Glaubinator/Radio-Telescope-RCA/README.md

# Radio-Telescope-RCA
Radio Telescope System for 1 GHz to 2 GHz Operation
