Glaubinator/Radio-Telescope-RCA/CAD/CAD.dwg/2pc Compressed 2 sheets.pdf

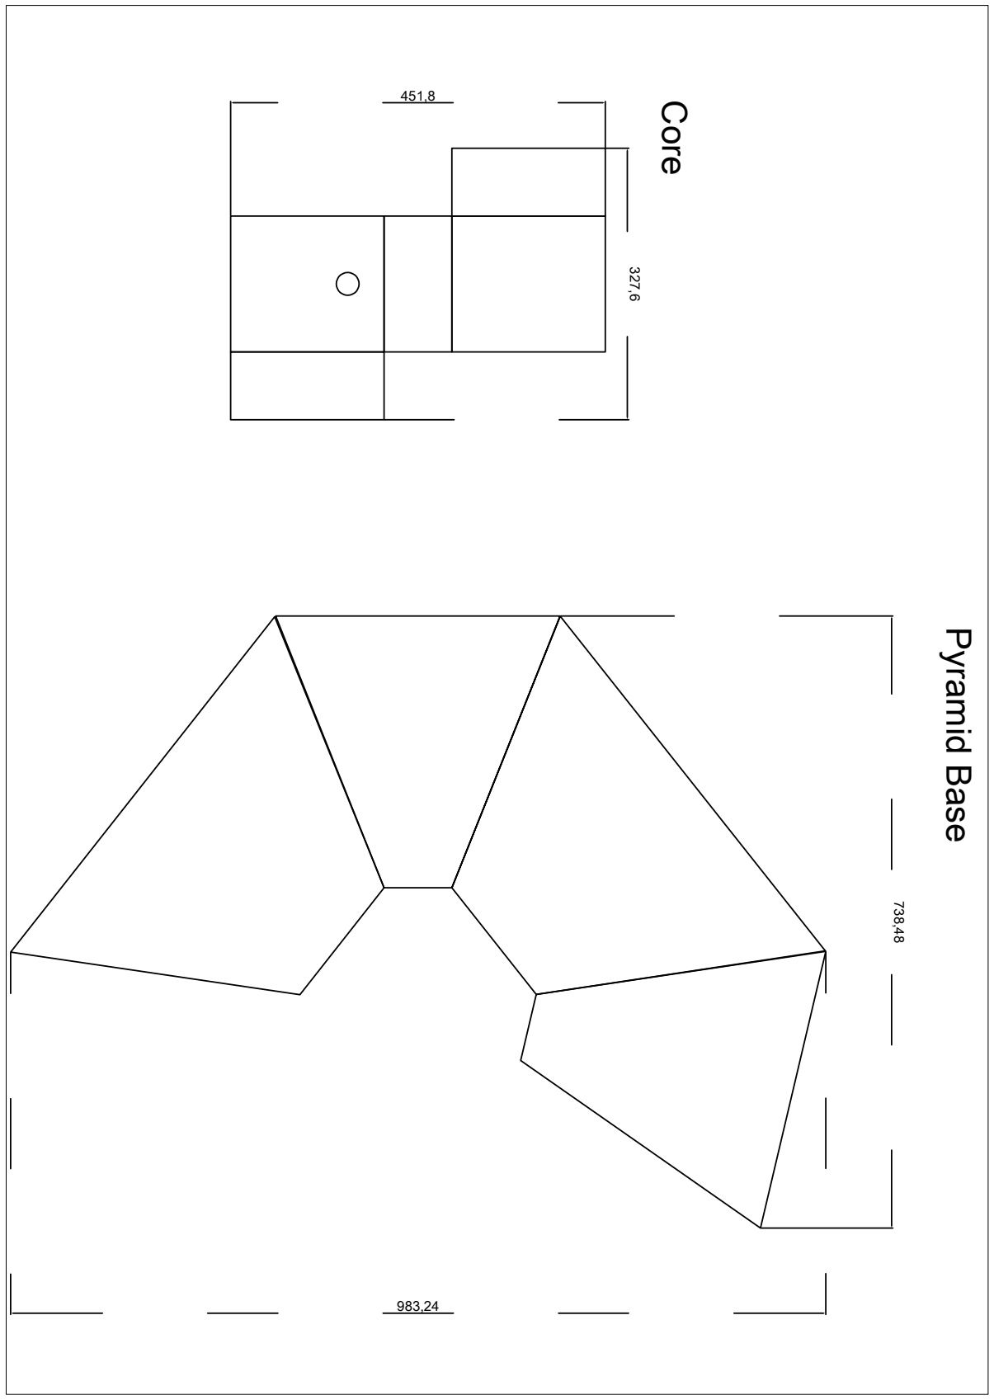
[picture p8: figure]
Pyramid Base ³²⁷,6; Core
