Glaubinator/Radio-Telescope-RCA/Project Info and Requirements/Decision Matrices/SDR Software.xlsx

SDR Softwares
Criteria | Weight | SDRAngel | SDR++ | GQRX
Ease of Use/UI | 3 | 2 | 4 | 5
Features/Expandability | 5 | 5 | 3 | 2
Recent Revisioning | 3 | 5 | 4 | 2
Score |  | 35 | 35 | 35
 | Criteria | Analysis
 | Ease of Use/UI | Most difficult, need to add interface windows for specific features, more of a canvas-style tool that can be configured to user's liking. | Bit more difficult to get use to, UI is understandable to navigate | Very easy to use, UI is simple
 | Features/Expandability | Best feature set compared to others, has special features for radio astronomy (rotator controls, skymaps, radio astronomy viewer) | Medium-low feature set, has similar features as GQRX but in a more presentable manner. Highlights common frequency ranges for HAM, FM, AM, etc. | Small feature set, really only meant for listening to radio waves. Lack of features may limit the expansibility of project later on.
 | Recent Revisioning | Dec 4, 2024 (As of 1/24/2025), Roughly Monthly Updates | Jan 3, 2025 (As of 1/24/2025), Nightly Builds | Nov 29, 2024 (As of 1/24/2025), updates semi-quarterly
 | Cost | FREE | FREE | FREE
 | Construction | Metal | Metal | Plastic
 | Compatibility with Software | Mostly compatible | Requires additional libraries | Mostly compatible
 | Cost | $340 | $133 | $233.25
