Glaubinator/Radio-Telescope-RCA/Project Info and Requirements/Functional Decomposition/Block Diagram/Level 0 and Level 1.png

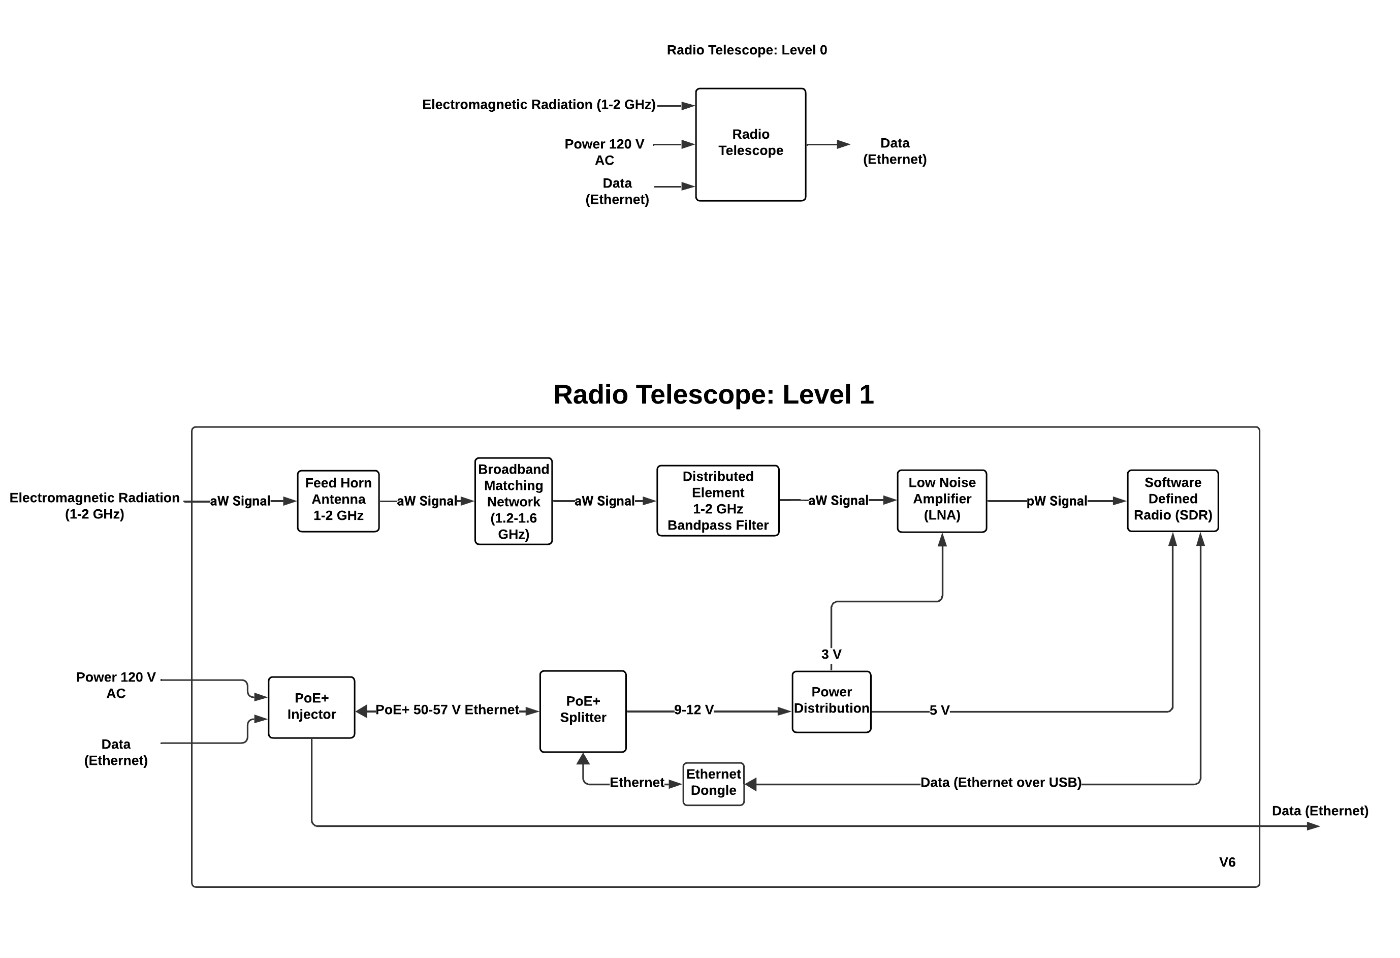
Project Info and Requirements/Functional Decomposition/Block Diagram/Level 0 and Level 1.png
