Glaubinator/Radio-Telescope-RCA/Project Info and Requirements/Gantt Chart/RCA RadioTelescope1.1.png

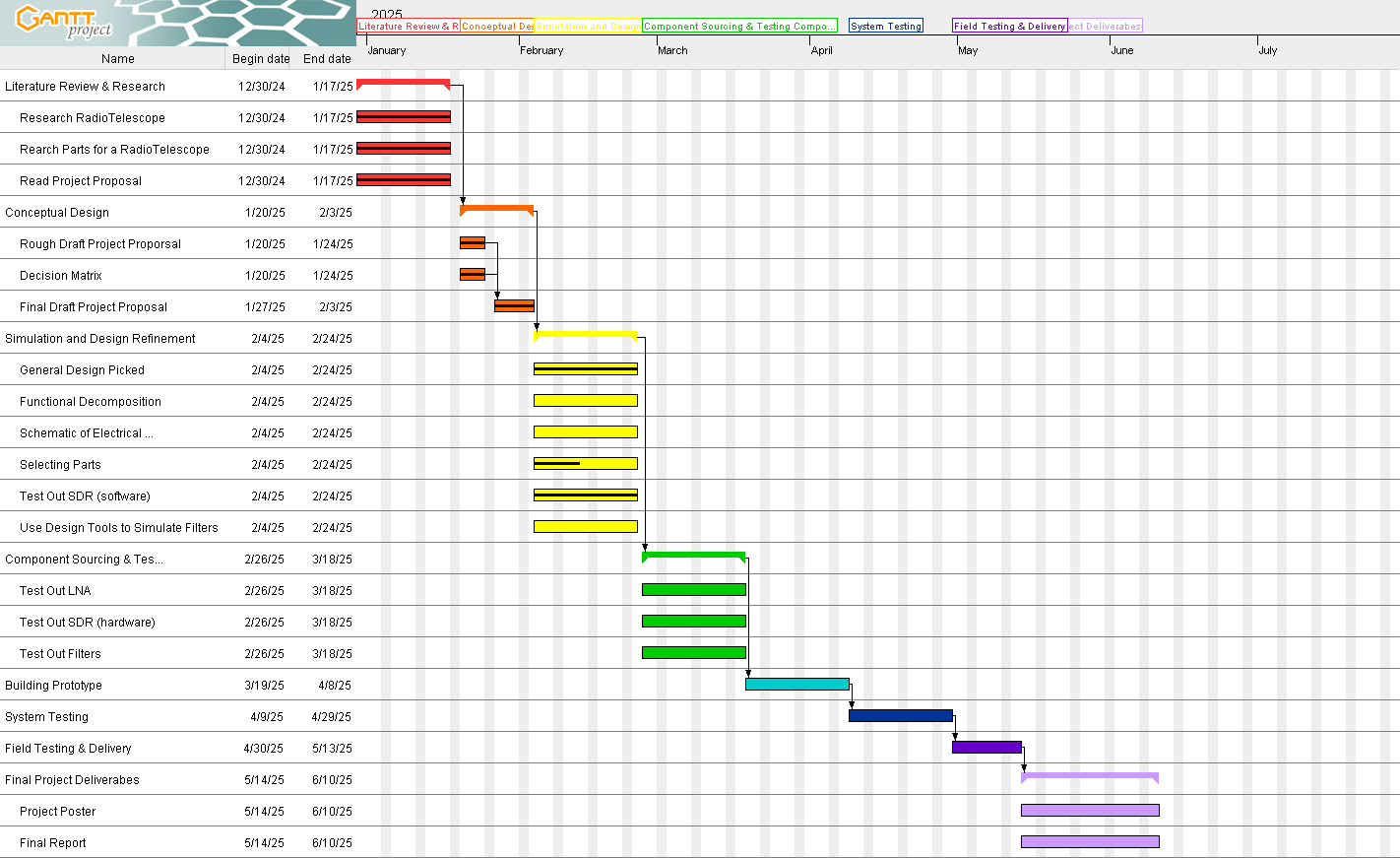
Project Info and Requirements/Gantt Chart/RCA RadioTelescope1.1.png
