Glaubinator/Radio-Telescope-RCA/Project Info and Requirements/Gantt Chart/RCA RadioTelescopeV1.2.png

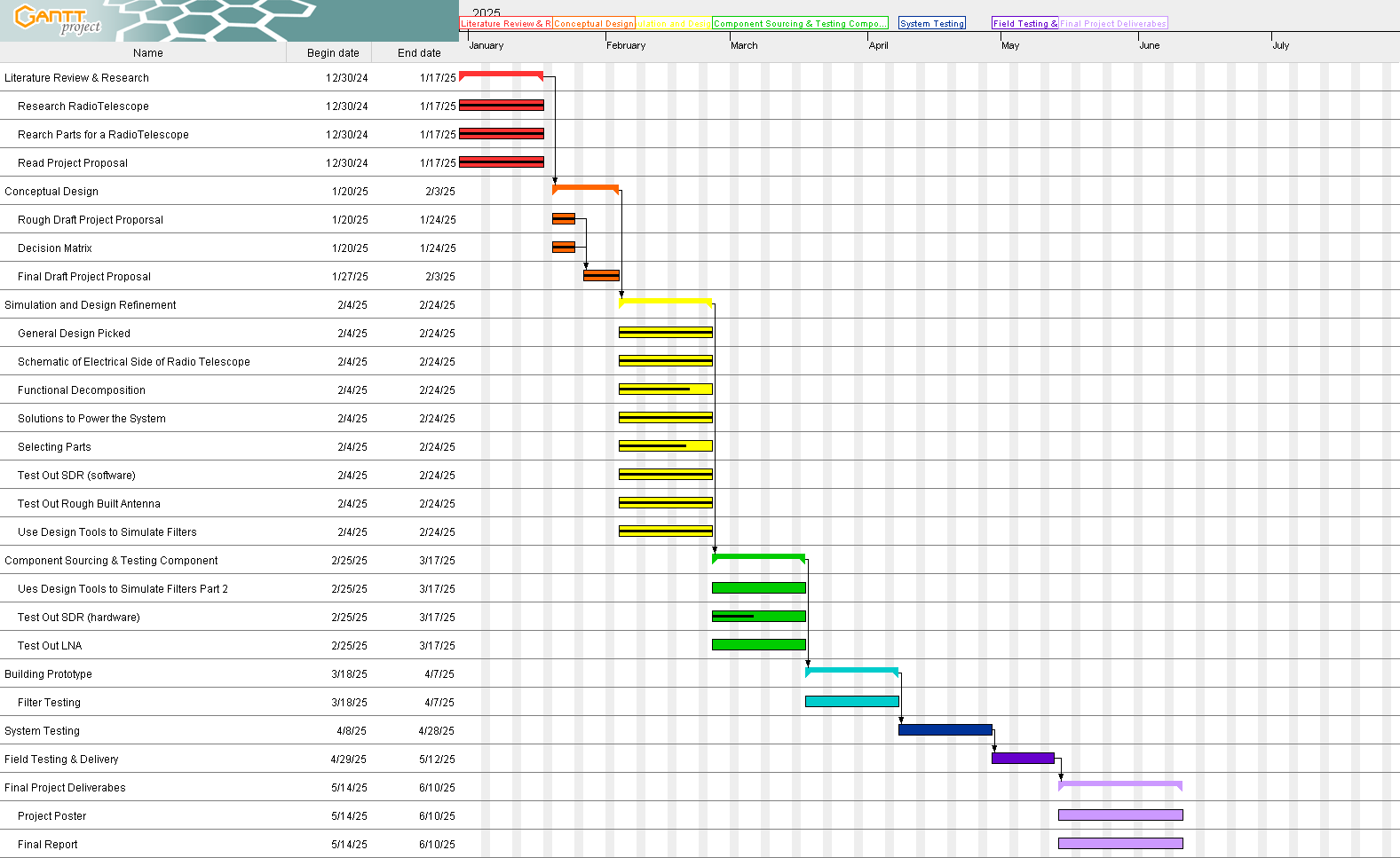
Project Info and Requirements/Gantt Chart/RCA RadioTelescopeV1.2.png
