Glaubinator/Radio-Telescope-RCA/Project Info and Requirements/Gantt Chart/RCA RadioTelescopeV1.4.png

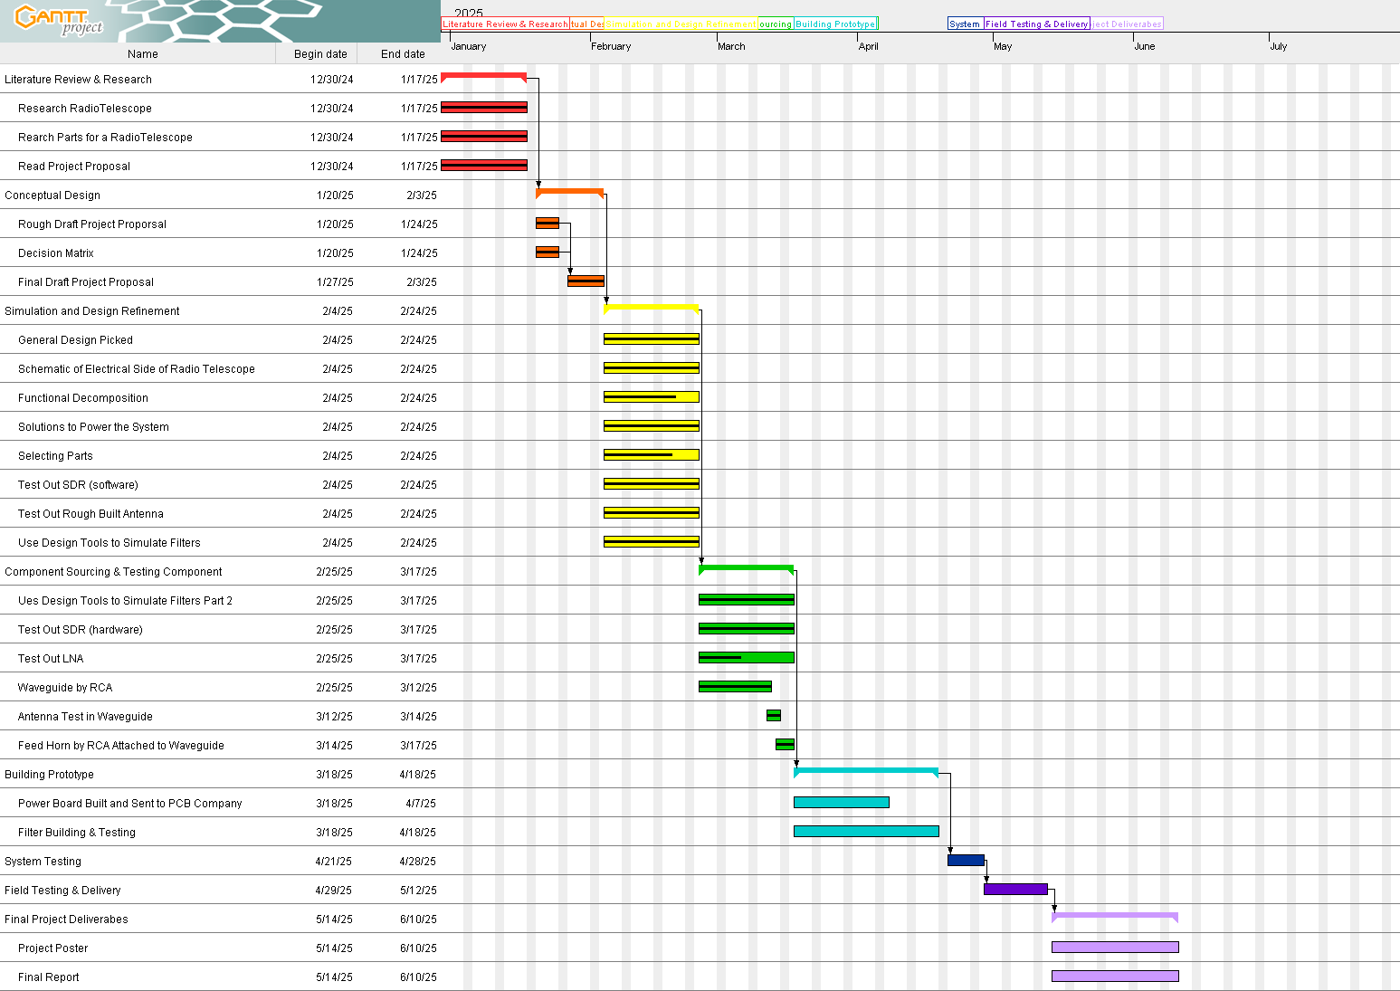
Project Info and Requirements/Gantt Chart/RCA RadioTelescopeV1.4.png
