Glaubinator/Radio-Telescope-RCA/Project Info and Requirements/Gantt Chart/RCA RadioTelescopeV1.6.png

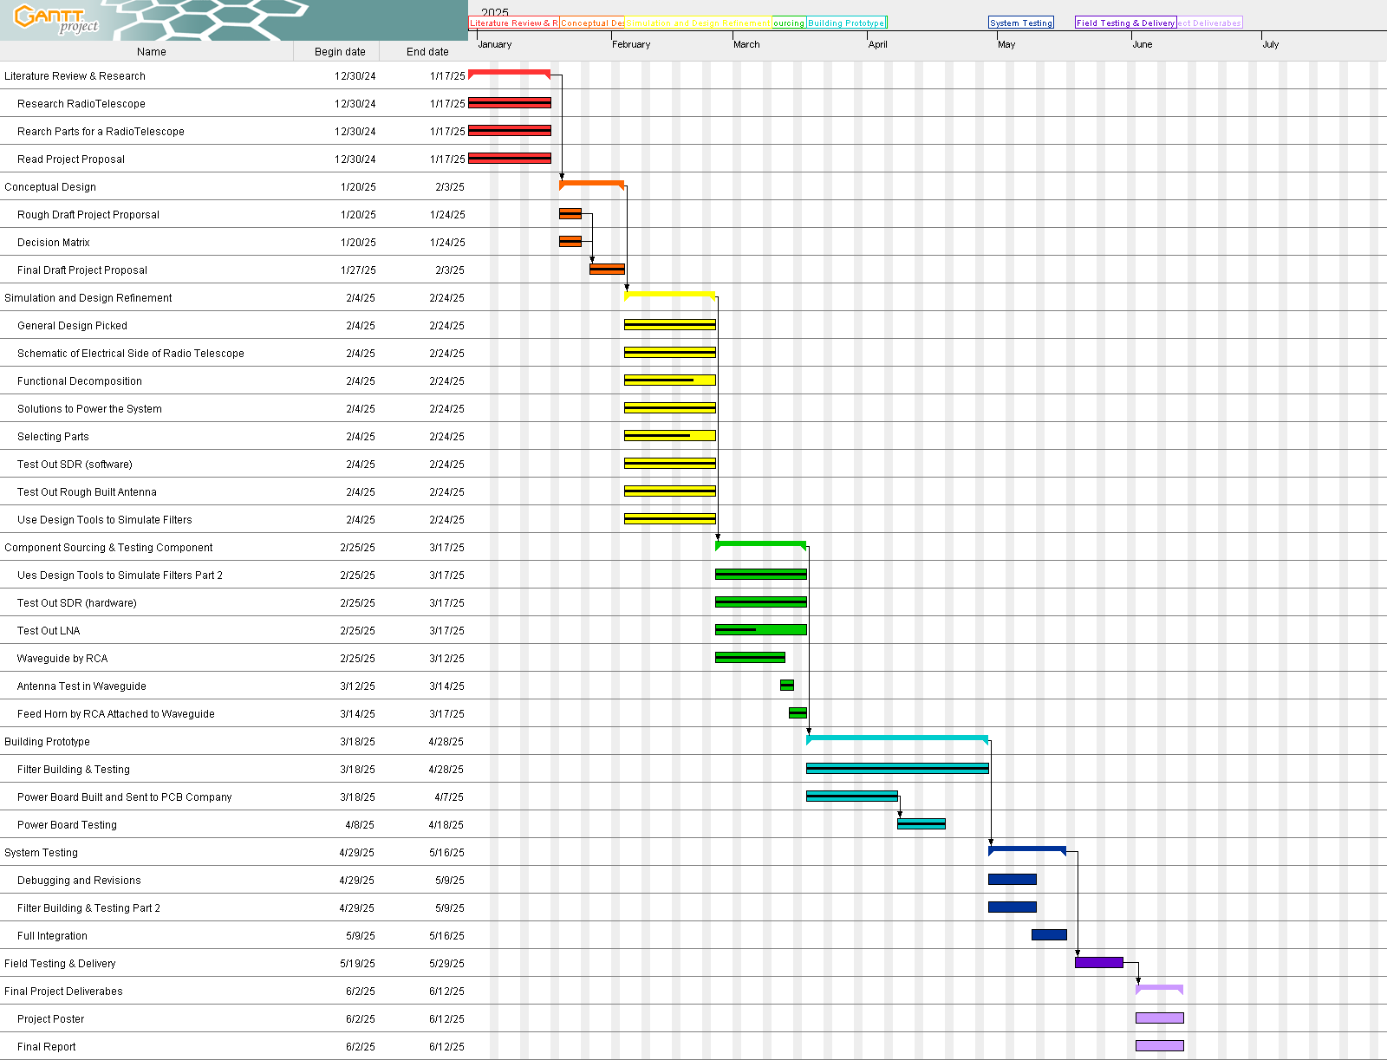
Project Info and Requirements/Gantt Chart/RCA RadioTelescopeV1.6.png
