Glaubinator/Radio-Telescope-RCA/Project Info and Requirements/Simulations/ADS/RF_Board V2/RFBOARDV2/pictures/ddsClipboard.png

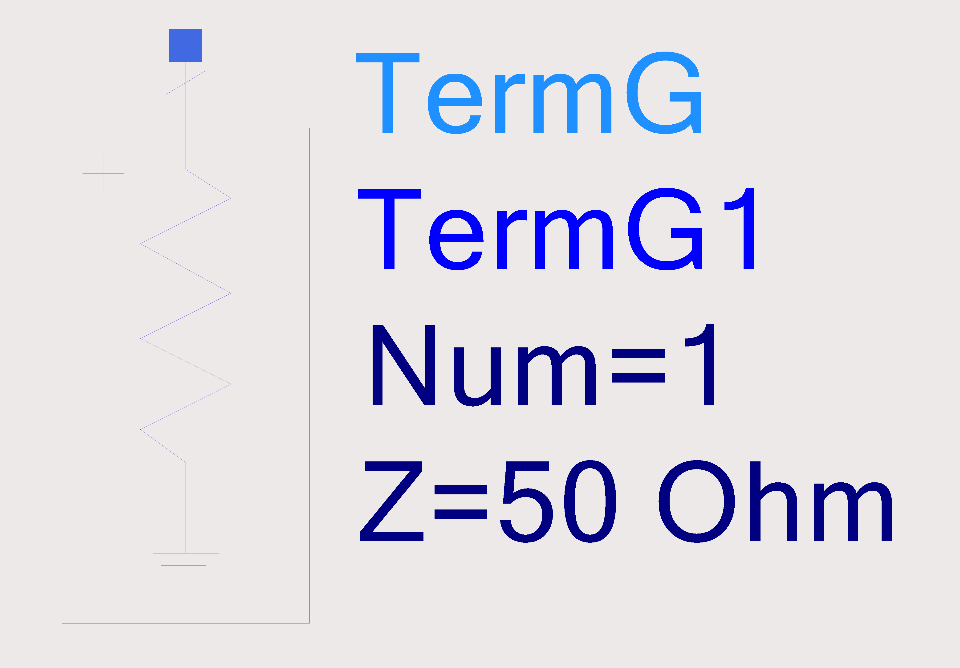
Project Info and Requirements/Simulations/ADS/RF_Board V2/RFBOARDV2/pictures/ddsClipboard.png
