Glaubinator/Radio-Telescope-RCA/CAD/3D Printables/Power.stp

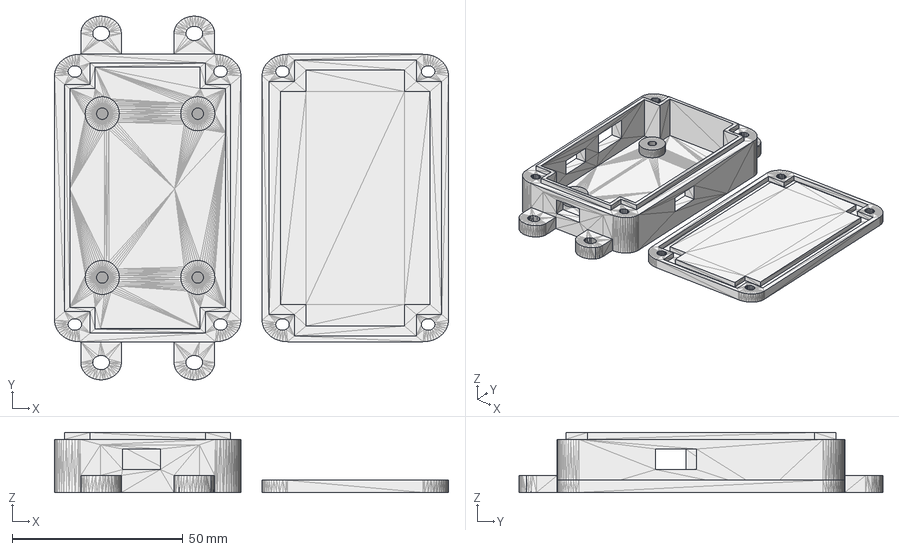
[picture p15: CAD file, 2025-05-12]
CAD/3D Printables/Power.stp
115.5 x 106.6 x 17.6 mm
