Glaubinator/Radio-Telescope-RCA/CAD/KiCad PCB-Schematic/RCA Radio Telescope (MultiPCB)/KiKit Exports/RF Boards/MDF_PCB_Rev1-3/Models/142-0711-821.stp

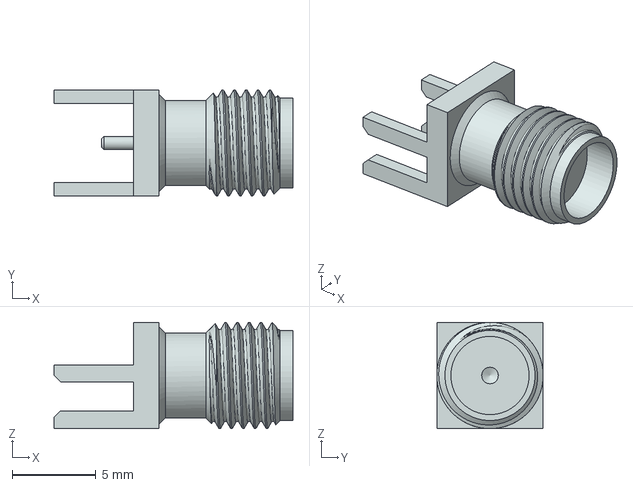
[picture p16: CAD file, 2025-05-06]
CAD/KiCad PCB-Schematic/RCA Radio Telescope (MultiPCB)/KiKit Exports/RF Boards/MDF_PCB_Rev1-3/Models/142-0711-821.stp
14.3 x 6.35 x 6.35 mm
