Glaubinator/Radio-Telescope-RCA/CAD/KiCad PCB-Schematic/RCA Radio Telescope (MultiPCB)/KiKit Exports/RF Boards/RFS_PCB_Rev1-4.step

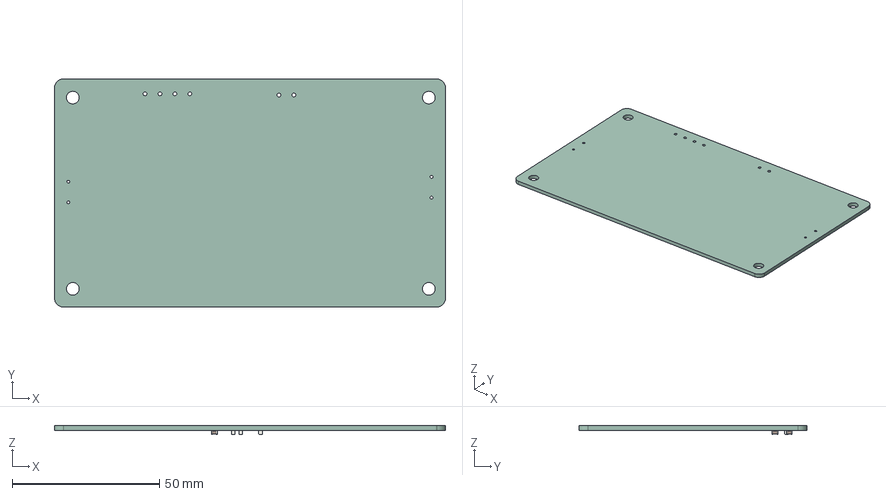
[picture p17: CAD file, 2025-05-07]
CAD/KiCad PCB-Schematic/RCA Radio Telescope (MultiPCB)/KiKit Exports/RF Boards/RFS_PCB_Rev1-4.step
132.9 x 77.5 x 2.90 mm
C_0805_2012Metric x 4
_autosave-RFS_PCB_Rev1-4_PCB
