Glaubinator/Radio-Telescope-RCA/CAD/3D Printables/MDF.stl

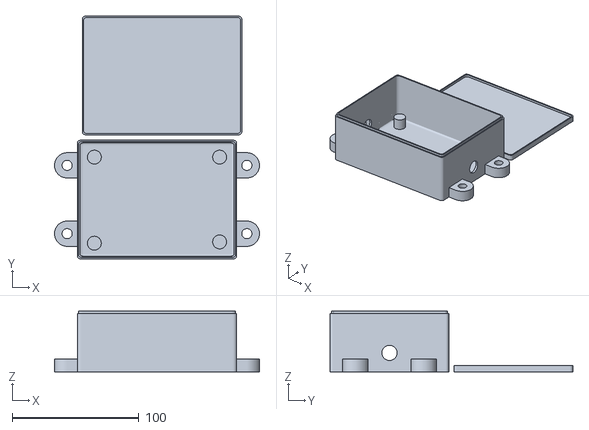
[picture p18: CAD file, 2025-05-12]
CAD/3D Printables/MDF.stl
162.0 x 192.0 x 48.0
