Glaubinator/Radio-Telescope-RCA/CAD/KiCad PCB-Schematic/RCA Radio Telescope (MultiPCB)/KiKit Exports/RF Boards/SF_PCB_Rev1-4.step

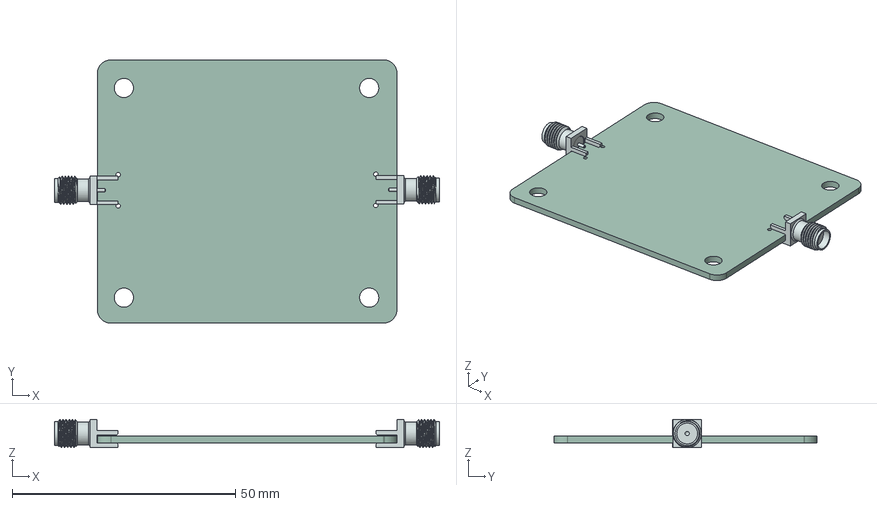
[picture p19: CAD file, 2025-05-06]
CAD/KiCad PCB-Schematic/RCA Radio Telescope (MultiPCB)/KiKit Exports/RF Boards/SF_PCB_Rev1-4.step
86.3 x 59.0 x 6.35 mm
SF_PCB_Rev1-4_PCB
