Glaubinator/Radio-Telescope-RCA/CAD/KiCad PCB-Schematic/RCA Radio Telescope (MultiPCB)/Models/DCU0008A.stp

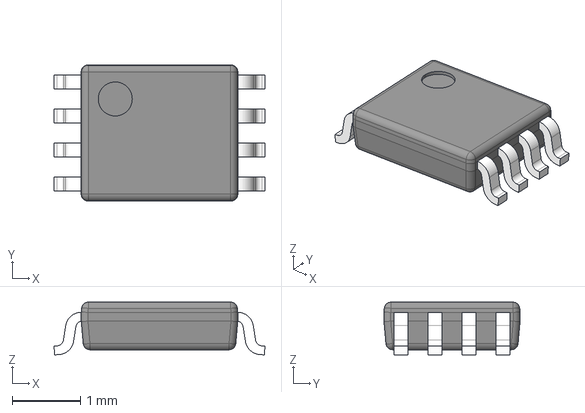
[picture p20: CAD file, 2025-04-02]
CAD/KiCad PCB-Schematic/RCA Radio Telescope (MultiPCB)/Models/DCU0008A.stp
3.10 x 2.00 x 0.775 mm
BODY-VSSOP
LEAD-VSSOP x 8
