Glaubinator/Radio-Telescope-RCA/CAD/3D Printables/RFS.stl

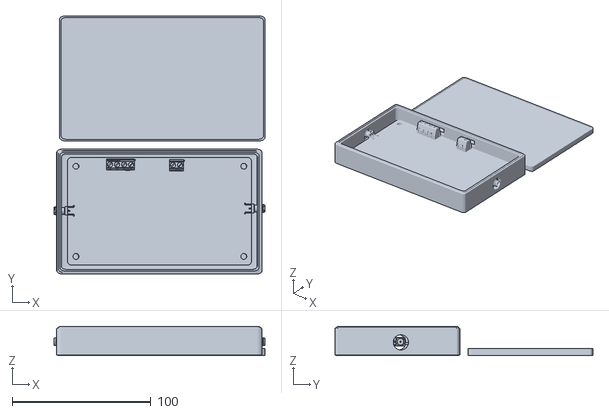
[picture p21: CAD file, 2025-05-09]
CAD/3D Printables/RFS.stl
152.0 x 186.0 x 21.0
