Glaubinator/Radio-Telescope-RCA/CAD/KiCad PCB-Schematic/RCA Radio Telescope (MultiPCB)/KiKit Exports/RF Boards/MSF_PCB_Rev1-3.step

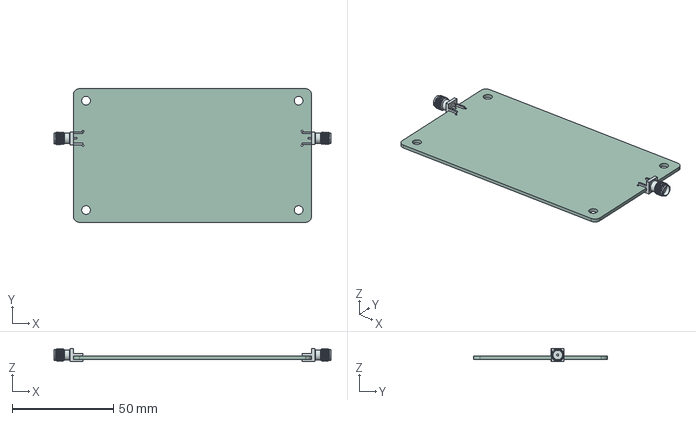
[picture p22: CAD file, 2025-05-06]
CAD/KiCad PCB-Schematic/RCA Radio Telescope (MultiPCB)/KiKit Exports/RF Boards/MSF_PCB_Rev1-3.step
136.8 x 66.0 x 6.35 mm
MSF_PCB_Rev1-3_PCB
