Glaubinator/Radio-Telescope-RCA/CAD/KiCad PCB-Schematic/RCA Radio Telescope (MultiPCB)/Models/SC-70_C5_MCH.step

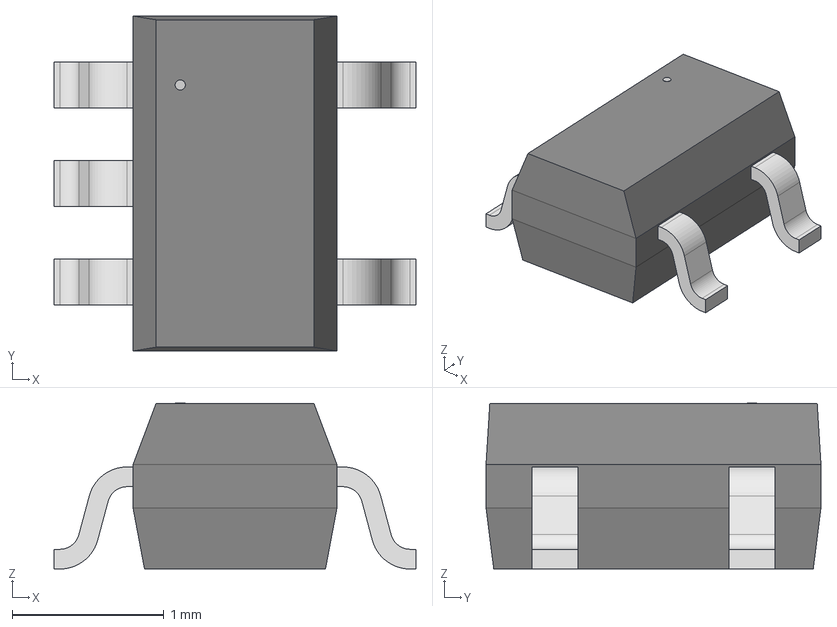
[picture p23: CAD file, 2025-04-02]
CAD/KiCad PCB-Schematic/RCA Radio Telescope (MultiPCB)/Models/SC-70_C5_MCH.step
2.39 x 2.21 x 1.09 mm
