Glaubinator/Radio-Telescope-RCA/CAD/3D Printables/MSF.stl

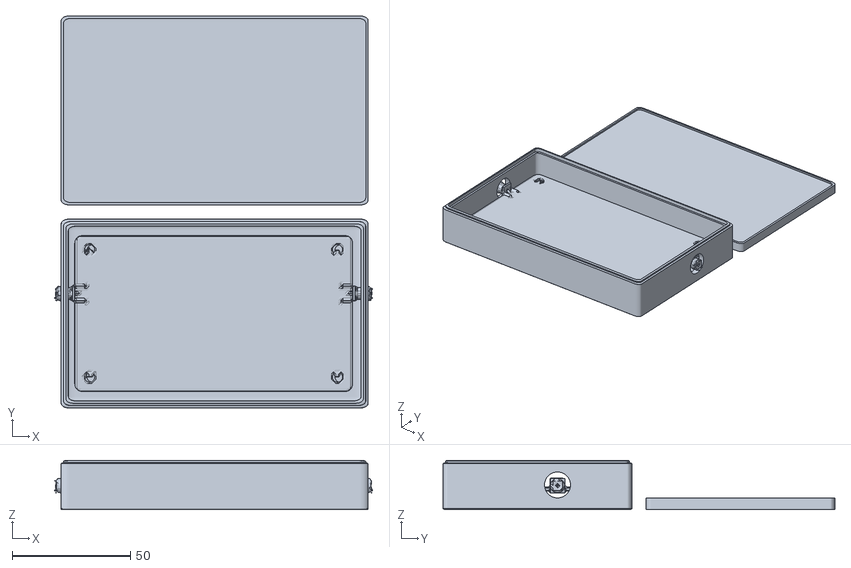
[picture p24: CAD file, 2025-05-07]
CAD/3D Printables/MSF.stl
135.0 x 166.0 x 21.0
