Glaubinator/Radio-Telescope-RCA/CAD/KiCad PCB-Schematic/RCA Radio Telescope (MultiPCB)/KiKit Exports/RF Boards/MDF_PCB_Rev1-3.step

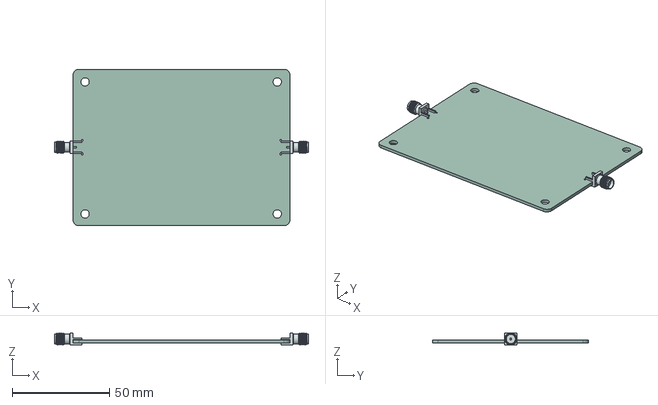
[picture p25: CAD file, 2025-05-06]
CAD/KiCad PCB-Schematic/RCA Radio Telescope (MultiPCB)/KiKit Exports/RF Boards/MDF_PCB_Rev1-3.step
130.8 x 80.5 x 6.35 mm
MDF_PCB_Rev1-3_PCB
