Glaubinator/Radio-Telescope-RCA/CAD/KiCad PCB-Schematic/RCA Radio Telescope (MultiPCB)/Models/MIC5365-1.8YC5-TR.step

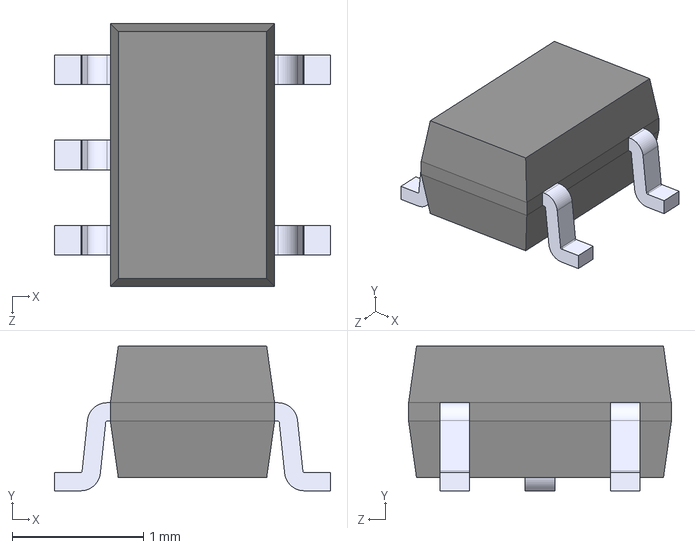
[picture p26: CAD file, 2025-04-02]
CAD/KiCad PCB-Schematic/RCA Radio Telescope (MultiPCB)/Models/MIC5365-1.8YC5-TR.step
2.10 x 1.10 x 2.00 mm
