Glaubinator/Radio-Telescope-RCA/CAD/3D Printables/SF.stl

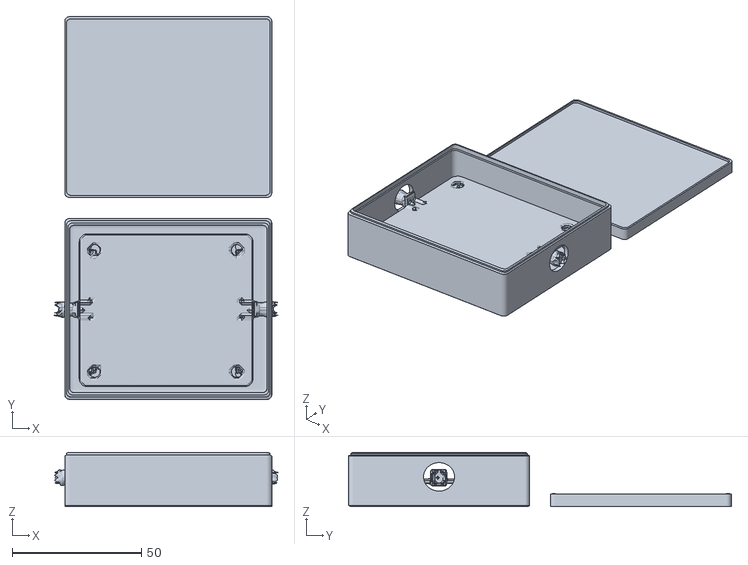
[picture p27: CAD file, 2025-05-07]
CAD/3D Printables/SF.stl
86.2 x 148.0 x 21.0
