Glaubinator/Radio-Telescope-RCA/CAD/KiCad PCB-Schematic/RCA Radio Telescope (MultiPCB)/Models/IND_CB_DRA73.step

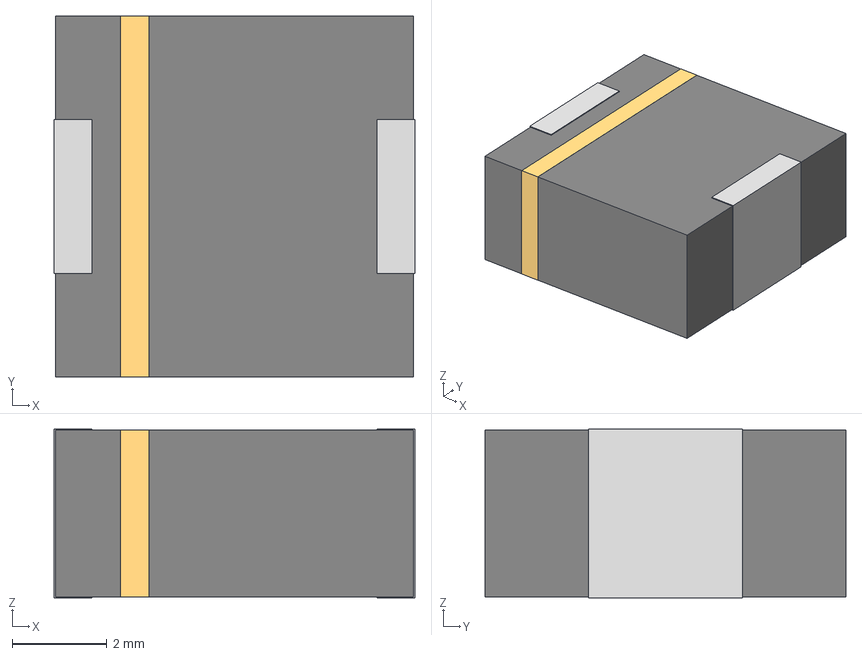
[picture p28: CAD file, 2025-03-29]
CAD/KiCad PCB-Schematic/RCA Radio Telescope (MultiPCB)/Models/IND_CB_DRA73.step
7.59 x 7.60 x 3.56 mm
