Glaubinator/Radio-Telescope-RCA/CAD/3D Printables/Power Print V1.stl

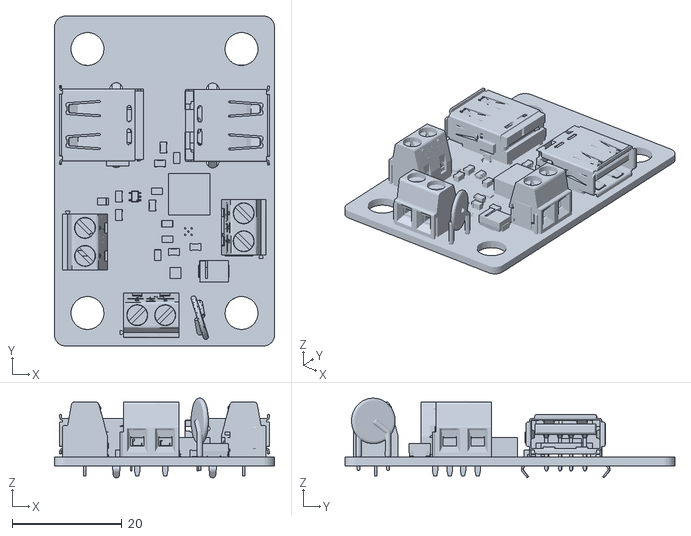
[picture p29: CAD file, 2025-04-26]
CAD/3D Printables/Power Print V1.stl
40.0 x 60.0 x 14.5
