Glaubinator/Radio-Telescope-RCA/CAD/KiCad PCB-Schematic/RCA Radio Telescope (MultiPCB)/Models/SMB_DIO.step

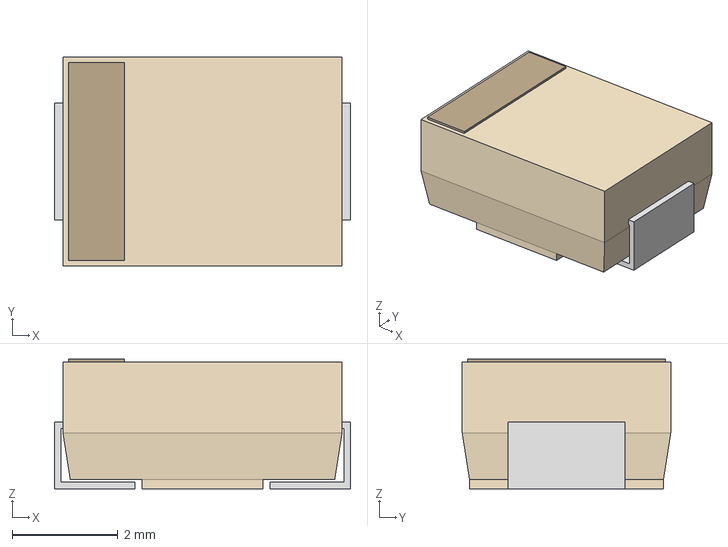
[picture p30: CAD file, 2025-03-29]
CAD/KiCad PCB-Schematic/RCA Radio Telescope (MultiPCB)/Models/SMB_DIO.step
5.59 x 3.94 x 2.45 mm
