Glaubinator/Radio-Telescope-RCA/CAD/KiCad PCB-Schematic/RCA Radio Telescope (MultiPCB)/Models/DFN2020E-6_STP.STP

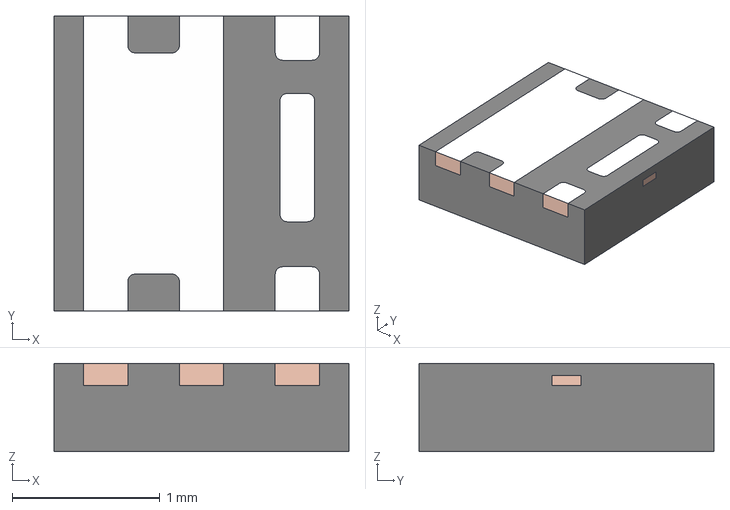
[picture p31: CAD file, 2025-03-29]
CAD/KiCad PCB-Schematic/RCA Radio Telescope (MultiPCB)/Models/DFN2020E-6_STP.STP
2.00 x 2.00 x 0.6 mm
Coumpound
LF
