Glaubinator/Radio-Telescope-RCA/CAD/KiCad PCB-Schematic/RCA Radio Telescope (MultiPCB)/Models/RGT0016C.stp

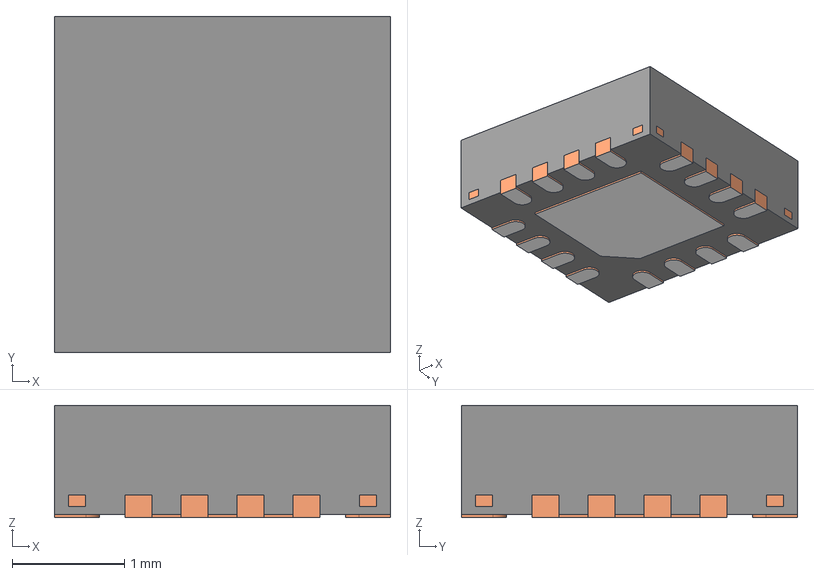
[picture p32: CAD file, 2025-03-29]
CAD/KiCad PCB-Schematic/RCA Radio Telescope (MultiPCB)/Models/RGT0016C.stp
3.00 x 3.00 x 1.00 mm
BODY-QFN
FRAME-RGT0016C
PIN1-ID
