Glaubinator/Radio-Telescope-RCA/CAD/KiCad PCB-Schematic/RCA Radio Telescope (MultiPCB)/Models/MAX8510EXK30T.step

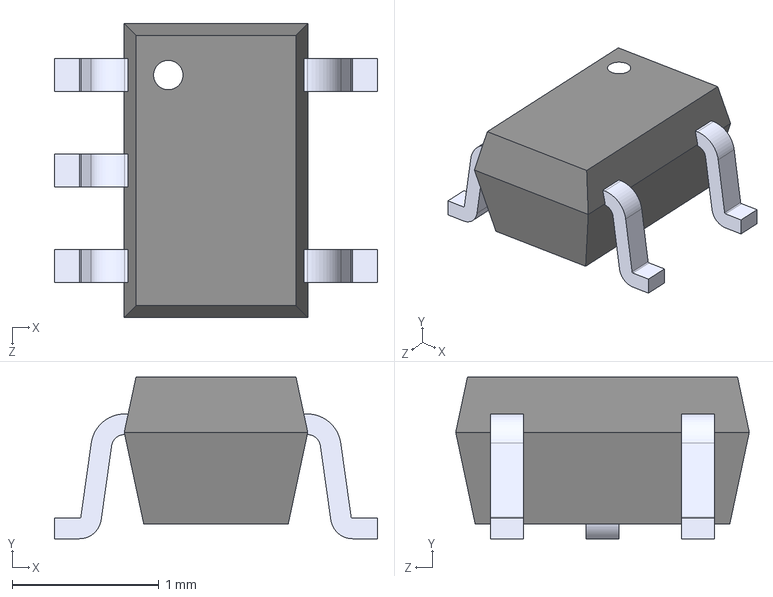
[picture p33: CAD file, 2025-03-28]
CAD/KiCad PCB-Schematic/RCA Radio Telescope (MultiPCB)/Models/MAX8510EXK30T.step
2.20 x 1.10 x 2.00 mm
