Glaubinator/Radio-Telescope-RCA/(list of files, cad)

Other CAD files:
CAD/CAD.dwg/2pc compressed-no-dims.dwg
CAD/Enclosure/Enclosure V2.dwg
CAD/FeedHorn/flange.dwg
Project Info and Requirements/Simulations/ADS/RF_Board V2/RFBOARDV2/mfg/RFBOARDV2_lib_1.6 GHz Matching With Filter/dxf/1.dxf
CAD/CAD.dwg/1pc-1sheet.dwg
CAD/FeedHorn/flange no filled.dwg
CAD/CAD.dwg/2pc compressed-no-dims-pdf.dwg
CAD/FeedHorn/flange union.dwg
CAD/CAD.dwg/Orgami-dim.dwg
CAD/FeedHorn/flange no fill.dwg
CAD/CAD.dwg/REG_HID_LAY_HTX.dwg
CAD/3D Printables/Power.stl
CAD/Enclosure/Enclosure.dwg
CAD/KiCad PCB-Schematic/RCA Radio Telescope (MultiPCB)/KiKit Exports/RF Boards/RFS_PCB_Rev1-3/Models/1729128.stp
CAD/KiCad PCB-Schematic/RCA Radio Telescope (MultiPCB)/KiKit Exports/RF Boards/RFS_PCB_Rev1-3/Models/1729144.stp
Project Info and Requirements/Simulations/ADS/Distrbuted Element Filter/simulation/ece413capstonecoupledlinedesign_lib/InterdigitalFilterOnly/layout/emSetup_MoM/proj.prt
Project Info and Requirements/Simulations/ADS/Distrbuted Element Filter/simulation/ece413capstonecoupledlinedesign_lib/InterdigitalFilterOnly/layout/emSetup_MoM/proj_out.prt
Project Info and Requirements/Simulations/ADS/Distrbuted Element Filter/simulation/ece413capstonecoupledlinedesign_lib/InterdigitalV3/layout/emSetup_MoM/proj.prt
Project Info and Requirements/Simulations/ADS/Distrbuted Element Filter/simulation/ece413capstonecoupledlinedesign_lib/InterdigitalV3/layout/emSetup_MoM/proj_out.prt
Project Info and Requirements/Simulations/ADS/Distrbuted Element Filter/simulation/ece413capstonecoupledlinedesign_lib/InterdigitalV3/layout/emSetup_export2EMPro/proj.prt
Project Info and Requirements/Simulations/ADS/RF_Board V2/RFBOARDV2/simulation/RFBOARDV2_lib/BroadbandmatchingNetwork/layout/emSetup_MoM/proj.prt
Project Info and Requirements/Simulations/ADS/RF_Board V2/RFBOARDV2/simulation/RFBOARDV2_lib/BroadbandmatchingNetwork/layout/emSetup_MoM/proj_out.prt
