Glaubinator/Radio-Telescope-RCA/Project Info and Requirements/RCA - Radio Telescope System for 1 GHz to 2 GHz Operation (UPDATED, 01_07_2025).pdf

## Project Proposal: Senior Engineering Capstone Design Project

## Title: Design and Build of a Radio Telescope System for 1 GHz to 2 GHz Operation

### 0. Background:

Rose City Astronomers (RCA) is an organization of amateur astronomers dedicated to the promotion, education, and enjoyment of astronomy among its members and the public. (https://www.rosecityastronomers.net)

RCA is beginning activity in radio astronomy for the interest of its members, and community. RCA has chosen to support educational projects with partner institutions. Initial projects in this area will explore suitable equipment for amateur radio astronomy observations and equip RCA with assets for use at its dark sky site, and for educational outreach in Greater Portland and other locations. The proposed project documented here is RCA’s first educational project specific to radio astronomy.

### 1. Project Objectives

The goal of this project is to design, build, and test a working prototype of a radio telescope system for operation in the 1 GHz to 2 GHz frequency range. The system will be used for amateur radio astronomy and include key components such as:

- A Low Noise Amplifier (LNA)
- A 3-meter parabolic dish antenna with 1/4 wave-in-horn waveguide feed
- A Software Defined Radio (SDR)
- FPGA-based signal processing and interfacing with a laptop PC running amateur radio astronomy software.

This system will meet stringent design specifications for performance, robustness, and cost while demonstrating the ability to detect weak celestial signals, such as those at 1.42 GHz (Hydrogen Line).

### 2. Customer Specifications

### 2.1 Low Noise Amplifier (LNA):

- Gain: ≥ 30 dB across 1 GHz – 2 GHz
- Noise Figure: ≤ 0.7 dB
- Power Supply: 12 V DC
- Power Consumption: ≤ 600 W over 12 hours continuous use
- Temperature Stability: -25°C to +60°C (passive heat sink if required)

### 2.2 Parabolic Dish Antenna:

- Diameter: 3 meters
- Surface Deviation: Root Mean Square deviation < wavelength/10 as fabricated and assembled
- Material: Aluminum mesh surface with structural tube frame
- Mounting: Manual adjustment ±180° azimuth, ±90° altitude without >3% parabola deformation from gravity load
- Wind Load Resistance: Withstand up to 90 mph winds without >3% parabola deformation
- Feed Design: 1/4 wave ground plane vertical, replaceable for each: 1 GHz, 1.42 GHz, and 2 GHz operating frequencies, within a horn and waveguide optimized for an f/D ratio = 0.45
- Aperture Efficiency: > 55%
- VSWR: < 1.5
- Antenna Temperature: < 100K at 30-degree elevation

### 2.3 Software Defined Radio (SDR):

- Compatible with Society of Amateur Radio Astronomy (SARA) standards
- Open-source software preferred; licenses ≤ $150 acceptable
- Integration with laptop PC via shielded USB

### 2.4 Signal Processing and Interface:

- FPGA-based processing to achieve:
- Signal Resolution: < 0.0714 rad (< 4.1 degrees) at 1.42 GHz
- Signal-to-Noise Ratio (SNR): ≥ 20:1 under system noise conditions
- Shielded coaxial connections for all critical signal paths

### 2.5 Operational Constraints:

- System budget: ≤ $1000 (BOM only)
- Prototype fabrication, assembly, and testing within 5 calendar months

### 3. Estimated Cost and Timeline

### 3.1 Bill of Materials (BOM) (Preliminary, to be defined by student

project plan and design):

Component Estimated Cost (USD)
Parabolic Dish Antenna (Aluminum Mesh, Frame, Hardware) $400
Low Noise Amplifier (COTS components) | $150
Dipole Feed with Horn and Waveguide | $100
Software Defined Radio (SDR) | $200
FPGA Development Board $100
Shielded Coaxial Cables and Connectors $50

Total Estimated BOM Cost: $1000

### 3.2 Project Timeline (5 Months) (Preliminary, to be defined by

student project plan and design):

Phase Duration | Key Deliverables
1. Literature Review & Research | Weeks 1–2 | Background analysis and requirements doc
2. Conceptual Design | Weeks 3–4 | Two designs with trade-off analysis
3. Simulation & Design Refinement Weeks 5–6 | Performance simulation and selection
4. Component Sourcing | Weeks 7–8 | Procurement of components
5. Prototype Assembly | Weeks 9–11 | Fully assembled system
6. System Testing | Weeks 12–14 | University lab validation
7. Field Testing & Delivery Week 15Deployment to customer dark-sky site

### 4. Design Options and Analysis

- LNA Options: Trade-off between custom design and Commercial Off-The-Shelf (COTS) options to ensure performance and cost balance.
- Antenna Options: Evaluate aluminum mesh construction versus solid dish for weight and cost efficiency.

- Waveguide Design: Horn design will be simulated and optimized for minimal signal loss and best f/D ratio.
- Signal Processing: FPGA platforms like Xilinx or Intel Cyclone evaluated for cost-effectiveness and compatibility.

### 5. Risks and Limitations

### 5.1 Technical Risks:

- Ensuring the LNA noise figure is maintained at ≤ 0.7 dB.
- Achieving sufficient parabolic surface accuracy under environmental loads.
- FPGA signal processing complexity and debugging time.

### 5.2 Budget Constraints:

- Components such as the parabolic dish and SDR must be sourced costeffectively to stay within the $1000 BOM limit.

### 5.3 Environmental Constraints:

- Wind and temperature stability of the dish system, ensuring robustness in the field.

### 5.4 Design Constraints:

- No cryogenic cooling or extreme temperature control systems will be incorporated into the system.
- The system should be modular and scalable for future upgrades or integration into other radio astronomy systems.
- The system shall include coaxial input and output connections and electronics shall be enclosed in a weather tight enclosure, suitably shielded for its specified performance.
- Anticipate that the final project report will be submitted to the “Radio Astronomy, Journal of the Society of Amateur Radio Astronomy.”
- Anticipate presenting the design, prototype performance, and project lessons learned at a General Meeting of the Rose City Astronomers. This is to be scheduled with Mark Martin, Teaching Assistant Professor, PSU.

- The design shall be documented, open source, accessible via arXiv, GitHub, or another reputable open-source server.

### 5.5 Expected Challenges and Risk Mitigation:

- Component Availability: Limited availability of specialized components might affect the timeline. Mitigation: Identify alternative components and commercial off the shelf subsystems early in the design process.
- Prototype Performance: Achieving the target performance metrics (gain, noise figure, etc.) within the specified cost may be challenging. Mitigation: Extensive simulation and design optimization will help reduce the number of prototype iterations required.
- Budget Constraints: Ensuring the BOM stays under $1000 USD could require strategic selection of components. Mitigation: Focus on costeffective transistors and minimize the use of expensive specialized components.

### 6. Skills Required for the Project Team

- Radio Frequency Engineering: For LNA design and waveguide feed analysis.
- Antenna Design and Simulation: Experience with CST Microwave Studio or similar software.
- FPGA Development: Proficiency in VHDL/Verilog and signal processing implementation.
- Software Integration: Experience with SDR hardware and amateur radio astronomy software.
- Mechanical Design: Structural design for the dish antenna and environmental stability.

### 7. Reporting and Milestones

- Weekly Progress Reports: Delivered to project advisor summarizing accomplishments, issues, and corrective actions.
- Key Milestones (Preliminary, to be defined by student project plan and design):
- Completion of conceptual design and simulation (Week 6).
- Assembly of the working prototype (Week 11).

- Validation testing in lab conditions (Week 14).
- Final deployment and field testing (Week 15).

### 8. Conclusion

This project proposal outlines a clear, cost-conscious, and performance-oriented plan to design, build, and test a functional radio telescope prototype. The system will meet the operational needs of amateur radio astronomy while adhering to the defined technical and financial constraints. Successful completion will demonstrate mastery of RF design, FPGA signal processing, and mechanical system development, making it an ideal capstone project for senior engineering students.

Prepared by: [RCA customer / mentor team]
Submission Date: [December 16, 2024]
Advisor/Instructor: [Andrew Greenberg / Mark Martin]
