Glaubinator/Radio-Telescope-RCA/CAD/CAD.dwg/1pc-1sheet-Layout1.pdf

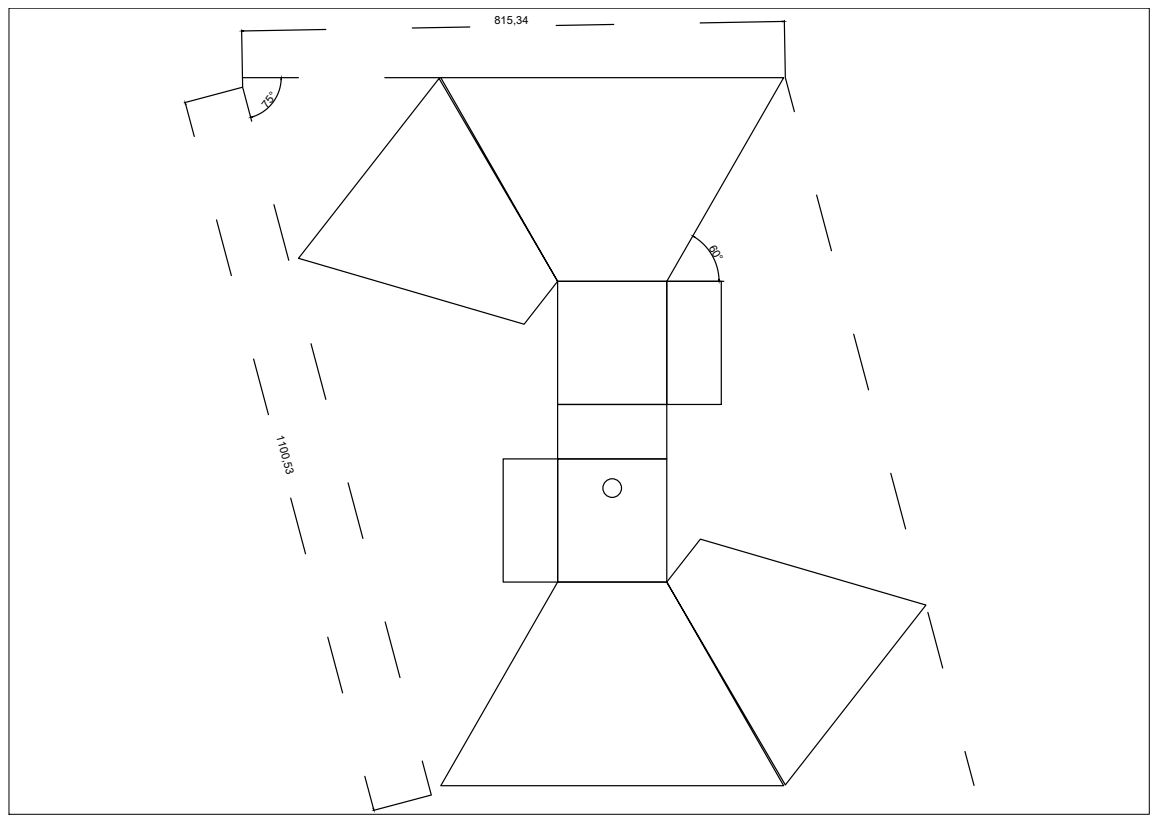
[picture p34: page 1]
