Glaubinator/Radio-Telescope-RCA/CAD/CAD.dwg/Orgami-Dim-Layout1.pdf

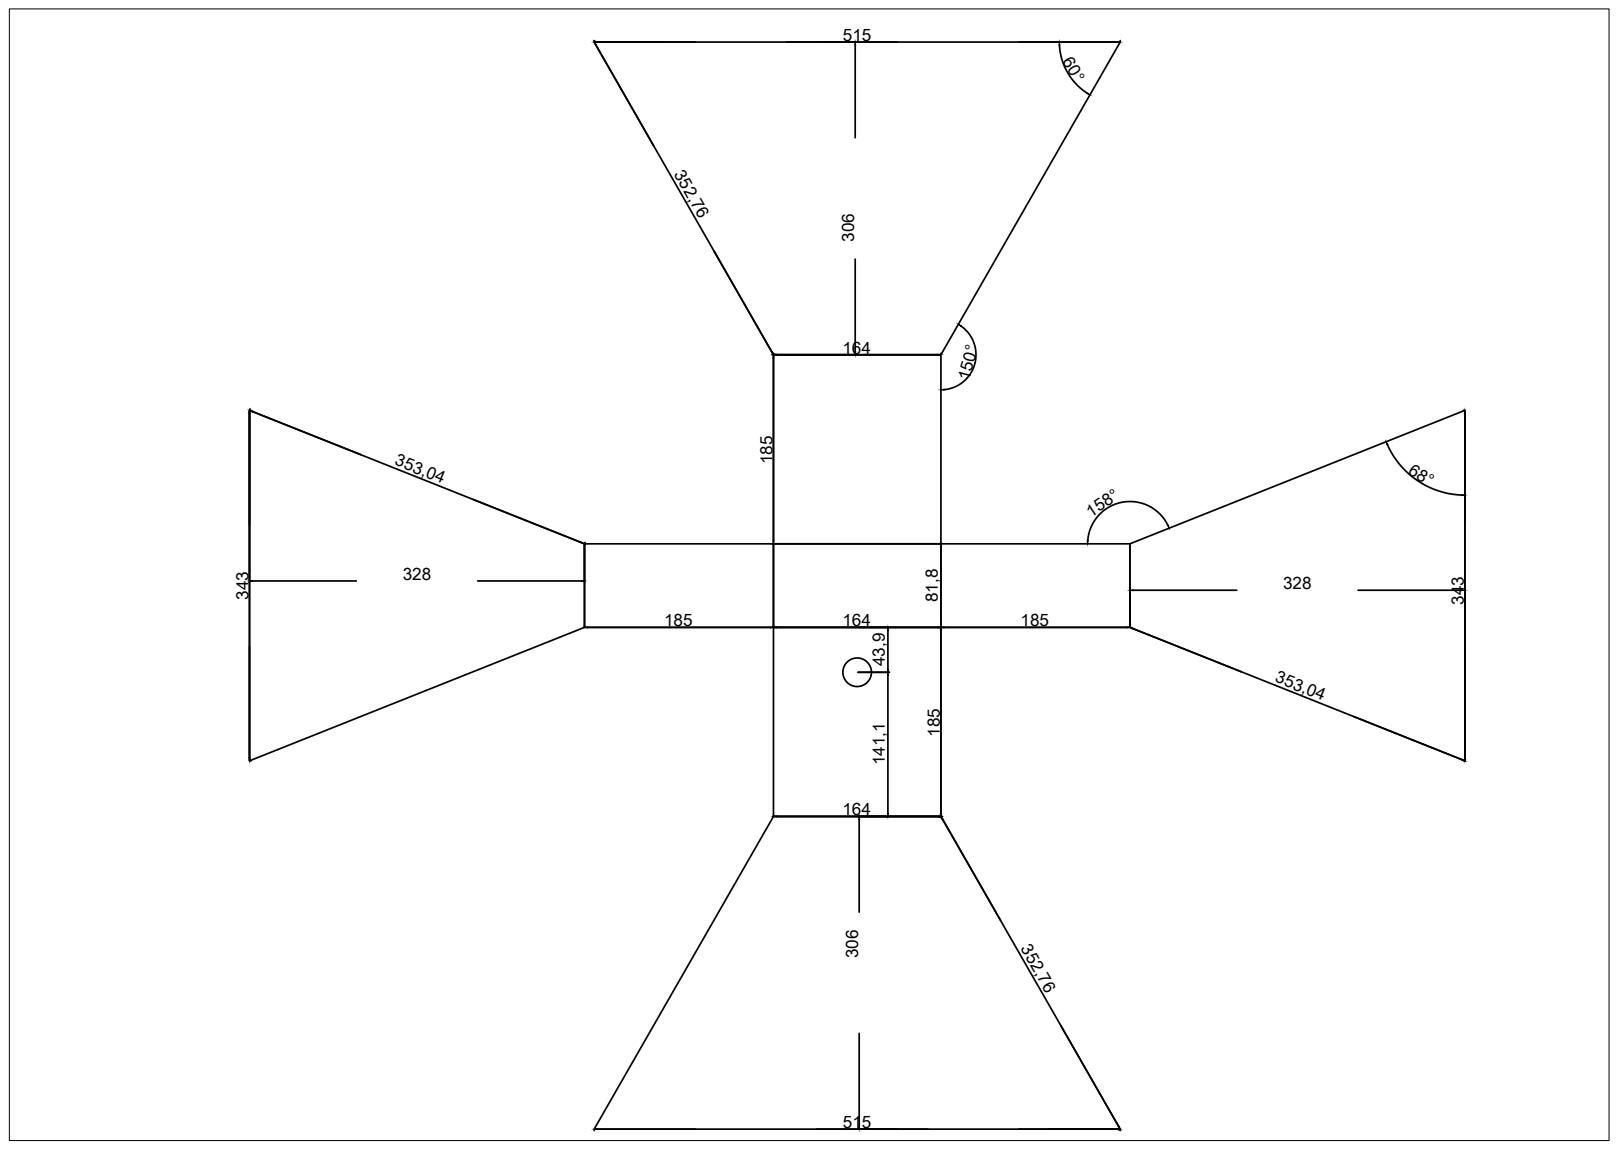
[picture p35: page 1]
