Glaubinator/Radio-Telescope-RCA/CAD/CAD.dwg/2D_Dims.pdf

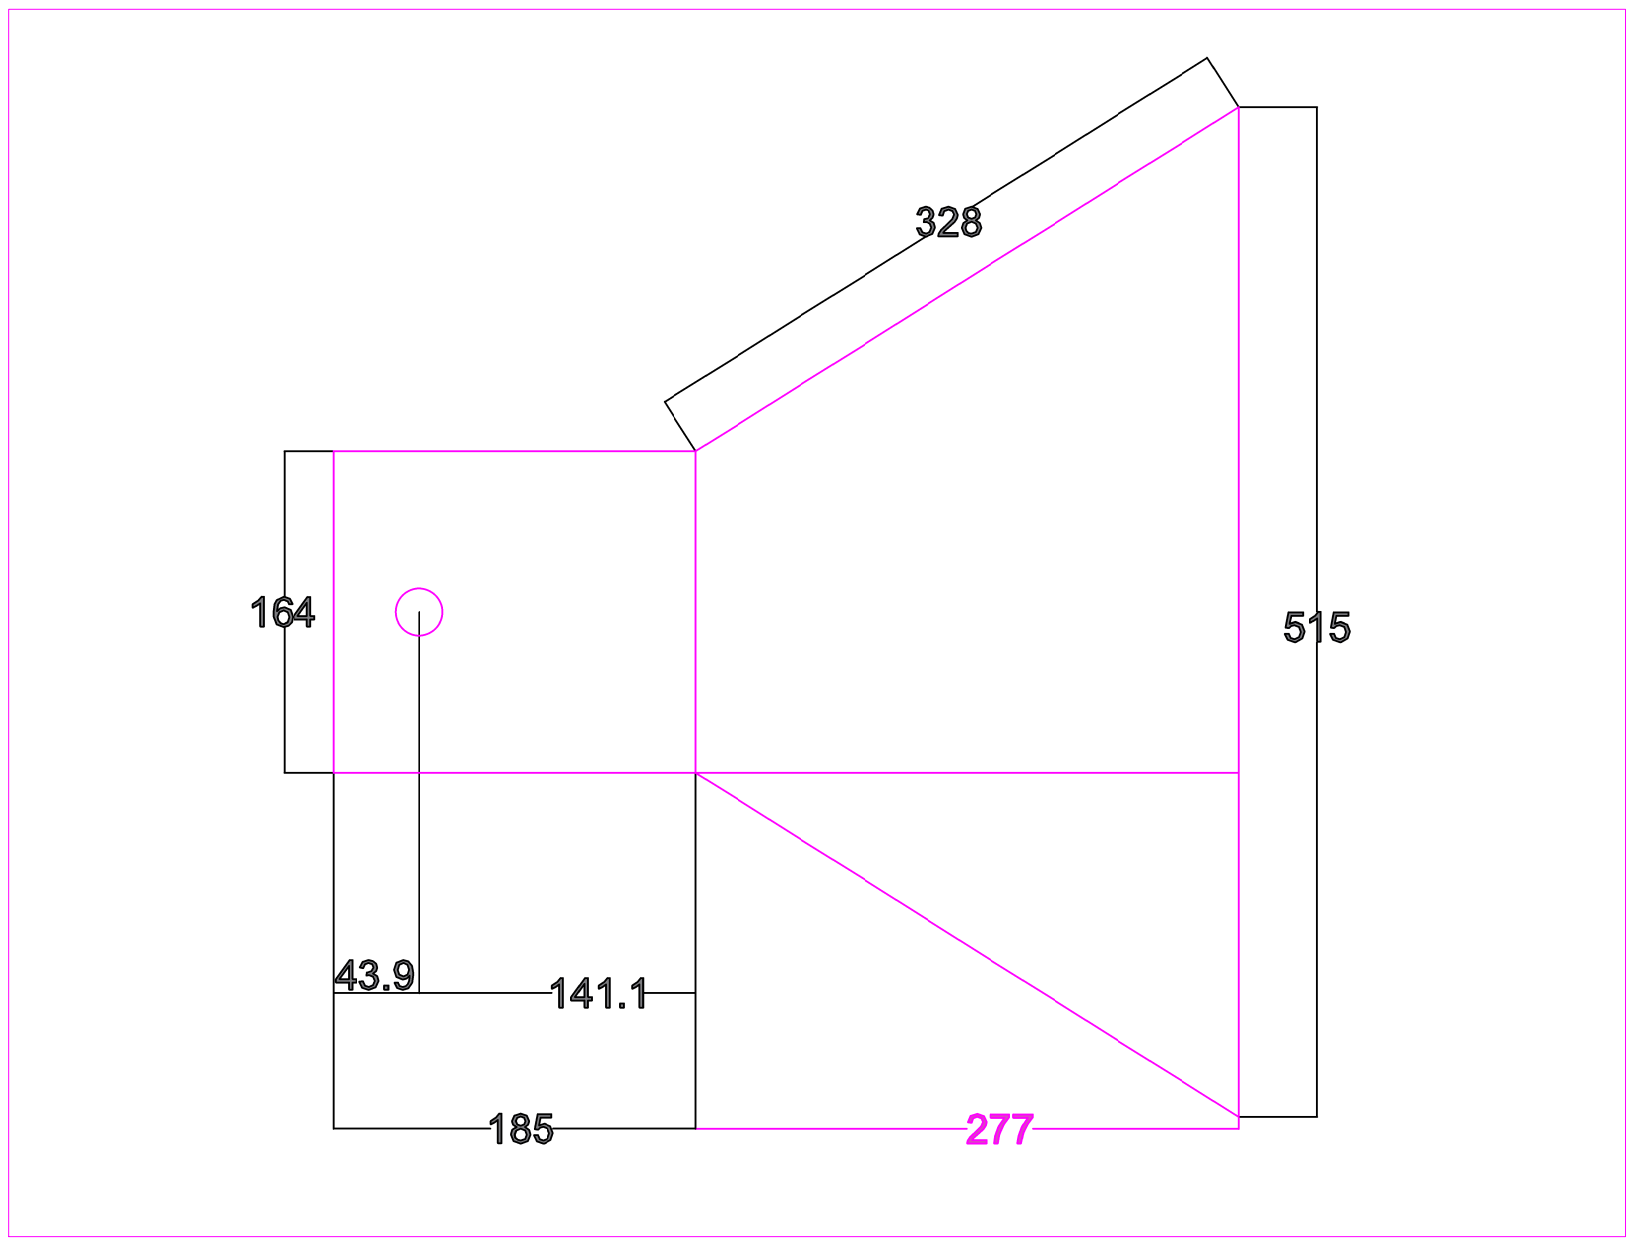
[picture p36: page 1]
