Glaubinator/Radio-Telescope-RCA/CAD/CAD.dwg/3D_Model.pdf

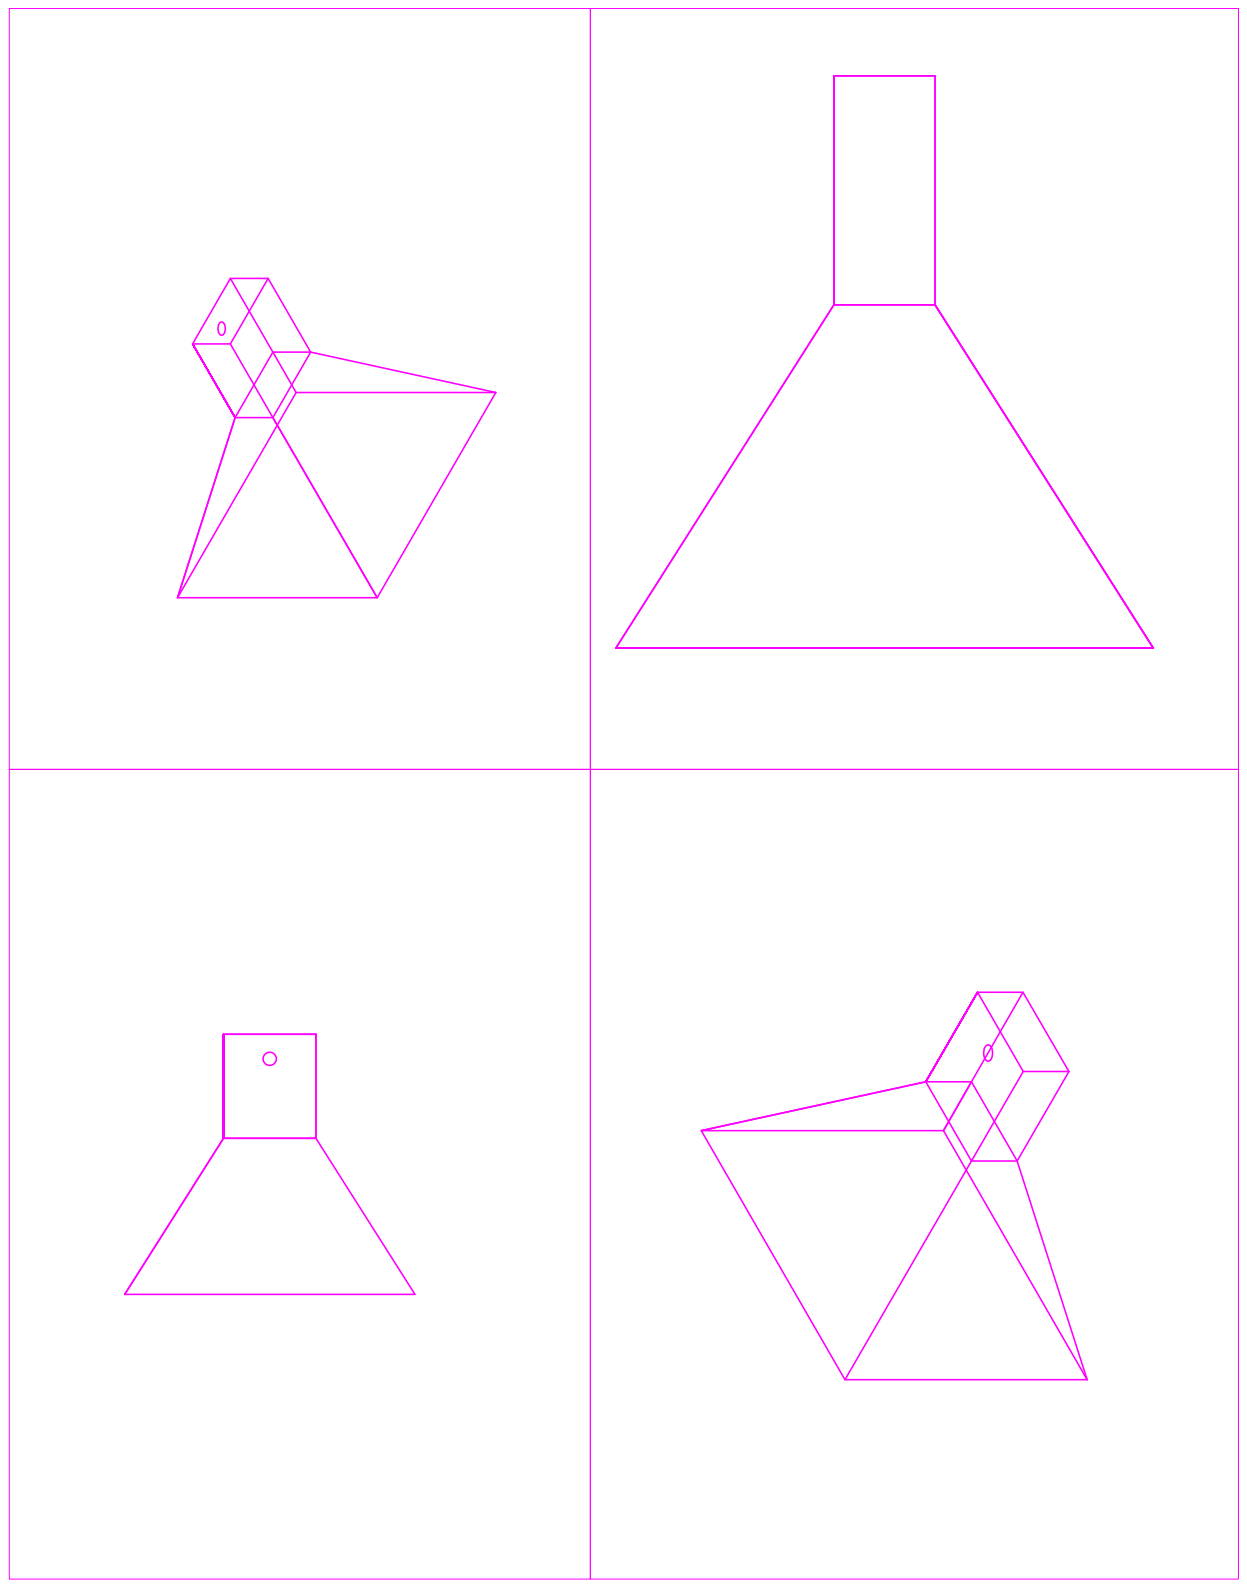
[picture p37: page 1]
