Glaubinator/Radio-Telescope-RCA/CAD/CAD.dwg/Pretty_ Dims.pdf

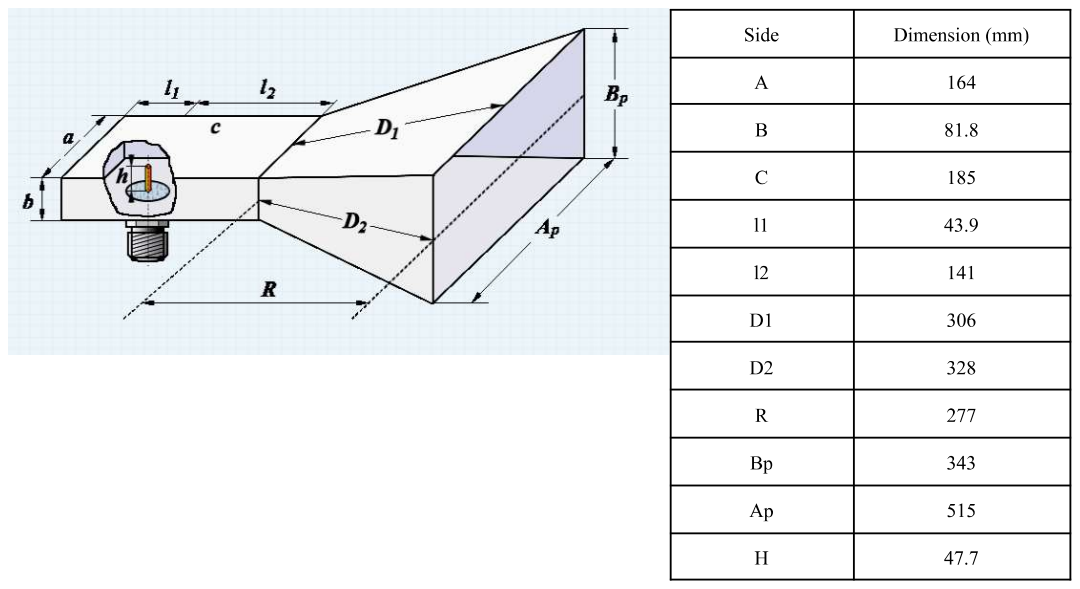
[picture p38: page 1]
