Glaubinator/Radio-Telescope-RCA/CAD/KiCad PCB-Schematic/RCA Radio Telescope (MultiPCB)/RCA Radio Telescope.kicad_pcb

## KiCad design CAD/KiCad PCB-Schematic/RCA Radio Telescope (MultiPCB)/RCA Radio Telescope.kicad_pcb (2025-06-11)

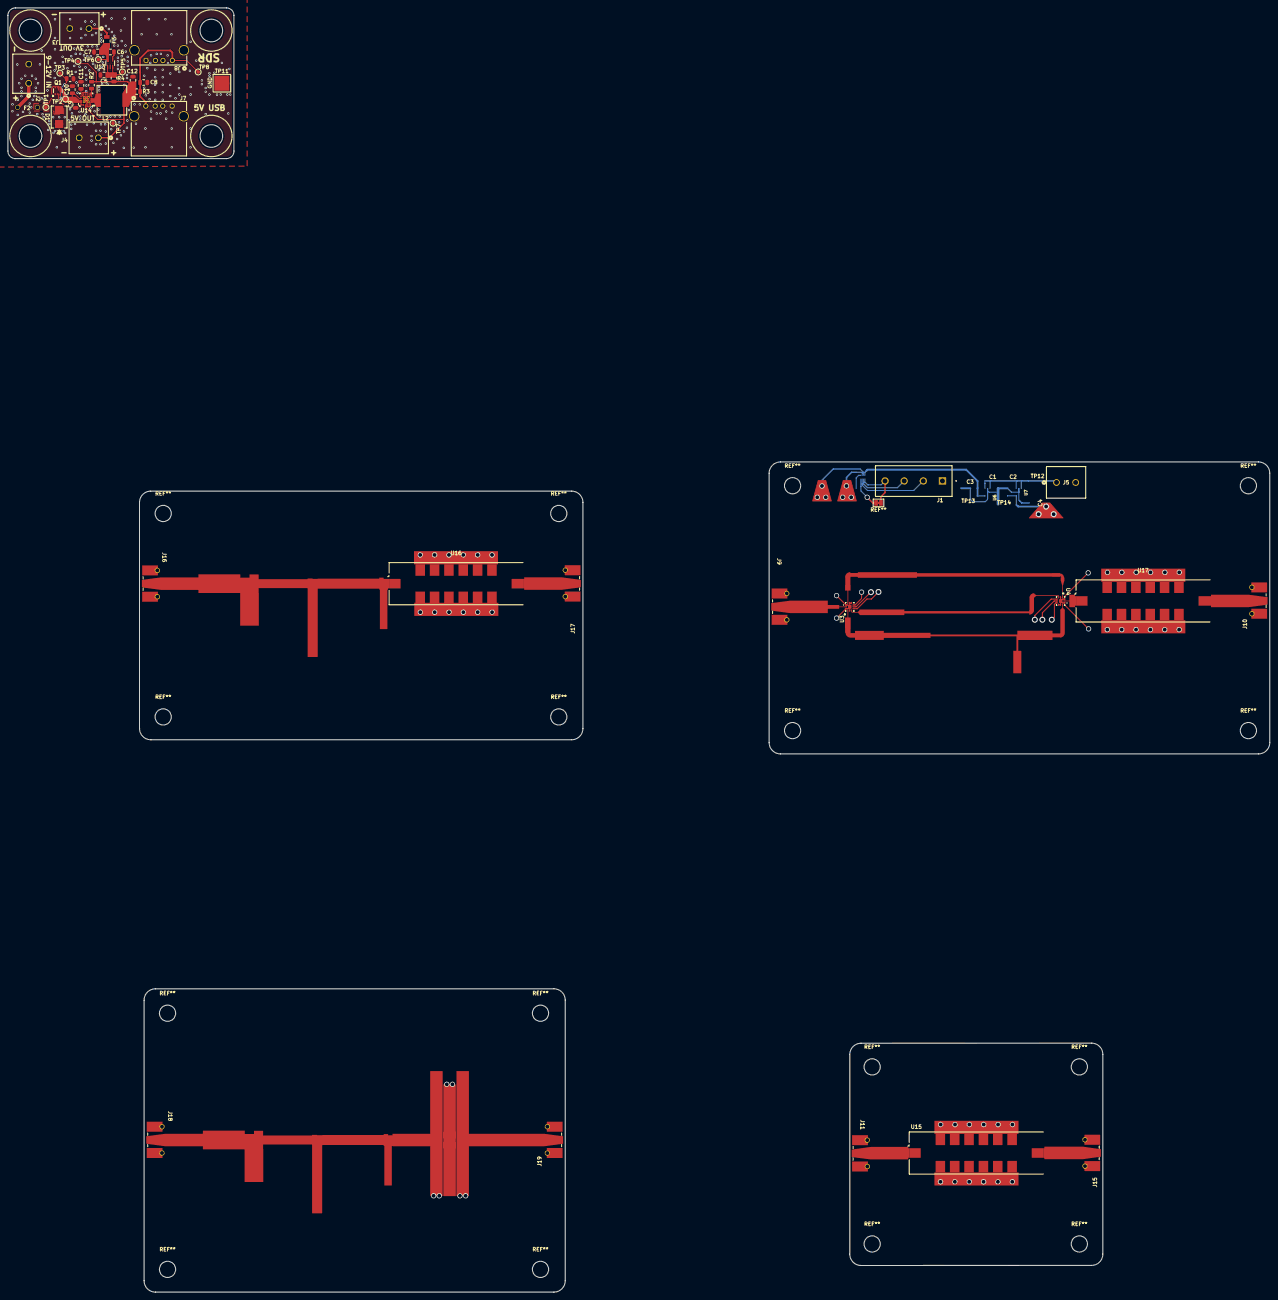
[picture p39: board RCA Radio Telescope.kicad_pcb from above]

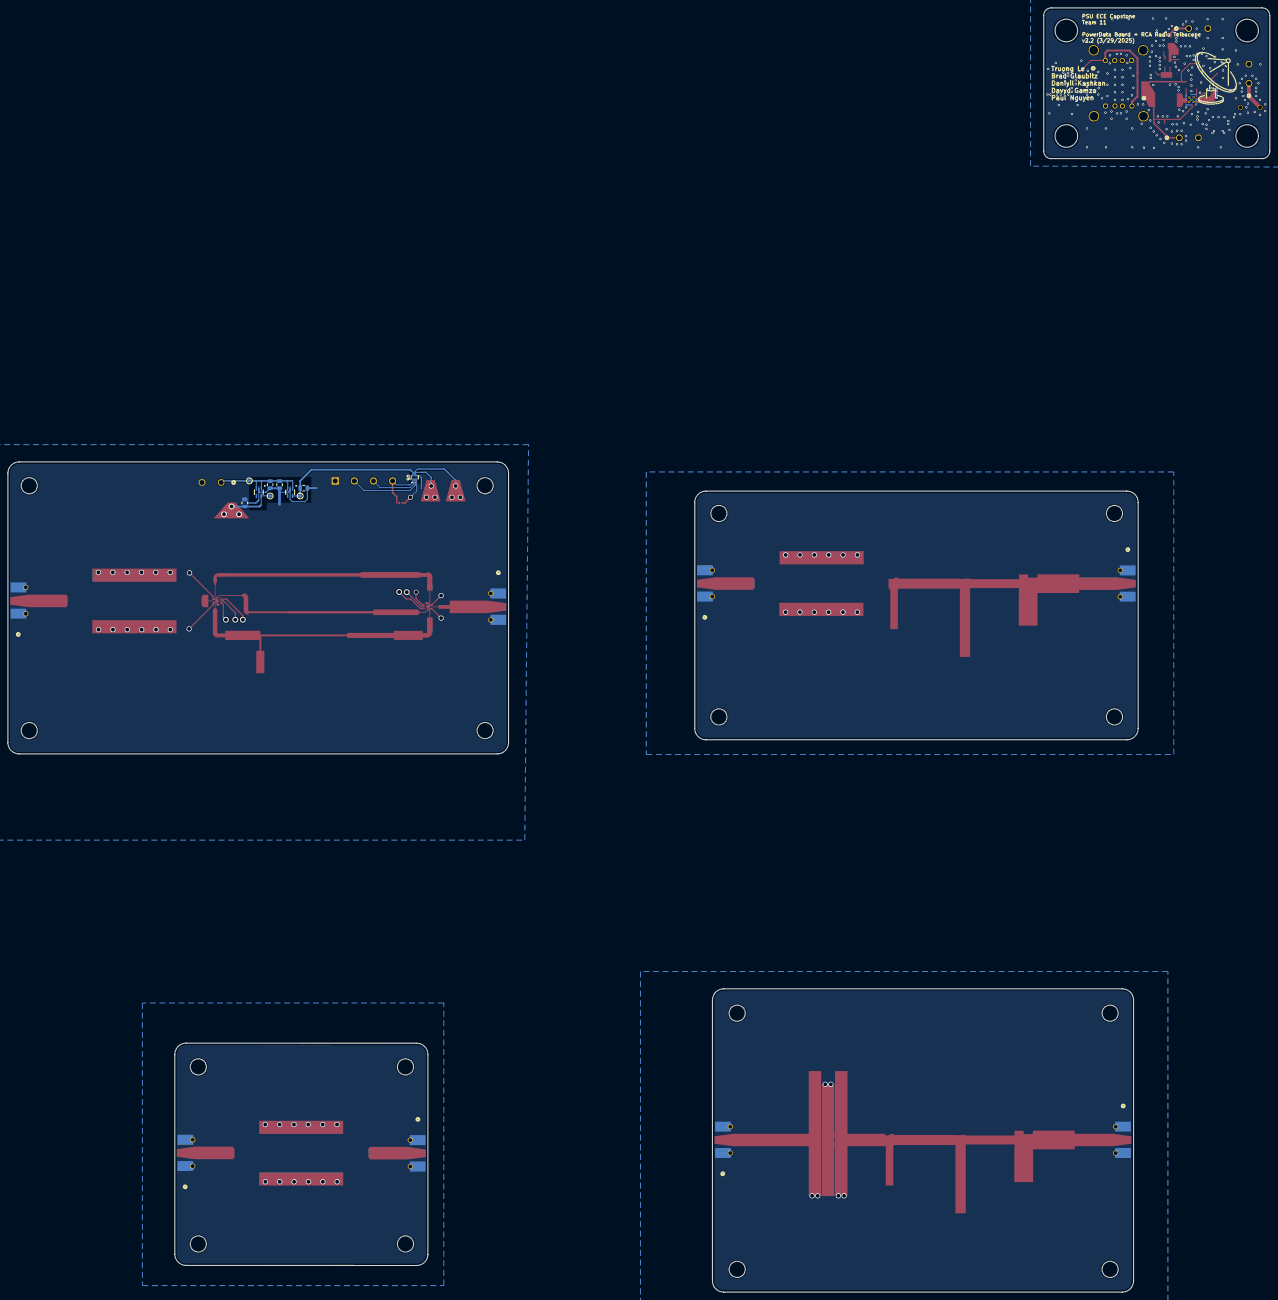
[picture p40: board RCA Radio Telescope.kicad_pcb from below]

Board: 2 copper layers, 335.0 x 340.9 mm, 63 parts (10 on the bottom side), 36 nets.

Parts:
C1, C2, C3, C4, C5, C7: 1 uF; C_0805_2012Metric
C6: 10 nf; C_0805_2012Metric
C8: 10 uF; C_0805_2012Metric
C9: 10uF; C_0805_2012Metric
C10: 0.1uF; C_0805_2012Metric
C11: 3.3nF; C_0805_2012Metric
C12: 22uF; C_0805_2012Metric
D1: SMBJ12A-13-F; SMB_DIO
F2: RGEF300K-2
F3: 0ZCK0020FF2G; 0ZCK_BEL
J1: Screw_Terminal_01x04; PHOENIX_1729144
J2: 9-12V From PoE Splitter; CONN_1729128_PXC
J3: 3V Out For LNA; CONN_1729128_PXC
J4: 5V Out For Filter Board; CONN_1729128_PXC
J5: 5V From SDR; CONN_1729128_PXC
J7, J8: USB_A; CONN_AU-Y1005-2_ASM
J9, J11, J15, J16, J17, J18, J19: ANT; CONN_142-0711-821_CIN
J10: FILTER_OUT; CONN_142-0711-821_CIN
L2: 2.2uH; IND_CB_DRA73
MDF: Kikit_Board_Label
MSF: Kikit_Board_Label
PD: Kikit_Board_Label
Q1: DMP4047LFDE-7; U-DFN2020-6_DIO
R1, R2: 100k; R_0805_2012Metric
R3, R4: 0; R_0805_2012Metric
RFS: Kikit_Board_Label
SF: Kikit_Board_Label
TP1: PROCTVIN; TestPoint_Pad_D1.0mm_Edit
TP2: 5VBUCKVIN; TestPoint_Pad_D1.0mm_Edit
TP3: G_PMOS; TestPoint_Pad_D1.0mm_Edit
TP4: 5VBUCKVOUT; TestPoint_Pad_D1.0mm_Edit
TP5: 3VLDOIN; TestPoint_Pad_D1.0mm_Edit
TP6: 3VLDOOUT; TestPoint_Pad_D1.0mm_Edit
TP7: 5VOUT; TestPoint_Pad_D1.0mm_Edit
TP8: 5VUSB; TestPoint_Pad_D1.0mm_Edit
TP11: GNDCLIP; TestPoint_Pad_4.0x4.0mm_Edit
TP12: FCTRL_VIN; TestPoint_Pad_D1.0mm_Edit
TP13: FCTRL_1V8; TestPoint_Pad_D1.0mm_Edit
TP14: FCTRL_3V3; TestPoint_Pad_D1.0mm_Edit
U3, U4: SKY13588-460LF; QFN12_SKY
U5: SN74AVC2T244DQER; SON35P140X100X40-8N
U6: MIC5365-1.8YC5-TR; SOT65P210X110-5N
U7: MIC5365-3.3YC5-TR; SOT65P210X110-5N
U13: MAX8510EXK30T; SOT65P210X110-5N
U14: TPS62133RGTR; RGT0016C
U15, U16: BPF-A1340+; Mini-Circuits_HQ1157
U17: BPF-A355; Mini-Circuits_HQ1157

Connections:
/Matched Distributive Filter/GND: J18.1 (In), J18.2 (Ext), J19.1 (In), J19.2 (Ext)
/Matched SMD Filter/GND: J16.2 (Ext), J17.2 (Ext), U16.2 (GND), U16.3 (GND), U16.4 (GND), U16.5 (GND), U16.6 (GND), U16.7 (GND), U16.9 (GND), U16.10 (GND), U16.11 (GND), U16.12 (GND), U16.13 (GND), U16.14 (GND)
/Matched SMD Filter/SIGNAL_IN: J16.1 (In), U16.1 (IN)
/Matched SMD Filter/SIGNAL_OUT: J17.1 (In), U16.8 (OUT)
/POWERDATA_GND: C5.2, C7.2, C8.2, C9.2, C10.2, C11.1, C12.2, D1.2, J2.2, J3.2, J4.2, J7.4 (GND), J8.4 (GND), R1.2, TP11.1, U13.2 (GND), U14.5 (FB), U14.6 (AGND), U14.7 (FSW), U14.8 (DEF), U14.15 (PGND), U14.16 (PGND), U14.17 (EP)
/PowerDataDistribute/VDD: F2.1, J2.1
/PowerDataDistribute/VOUT_3V: F3.2, J3.1
/PowerDataDistribute/VOUT_5V: C12.1, J4.1, L2.2, R2.1, R3.2, R4.2, TP4.1, TP7.1, U14.14 (VOS)
/RFS_GND: C1.2, C2.2, C3.1, C4.1, J1.1, J5.2, J9.2 (Ext), J10.2 (Ext), U3.2 (GND), U3.7 (GND), U3.8 (GND), U3.10 (GND), U3.12 (GND), U3.13 (EPAD), U4.2 (GND), U4.7 (GND), U4.8 (GND), U4.10 (GND), U4.12 (GND), U4.13 (EPAD), U5.5 (GND), U6.2 (GND), U7.2 (GND), U17.2 (GND), U17.3 (GND), U17.4 (GND), U17.5 (GND), U17.6 (GND), U17.7 (GND), U17.9 (GND), U17.10 (GND), U17.11 (GND), U17.12 (GND), U17.13 (GND), U17.14 (GND)
/RFSwitchFilter/5V_IN: C1.1, C2.1, J5.1, TP12.1, U6.1 (VIN), U6.3 (EN), U7.1 (VIN), U7.3 (EN)
/RFSwitchFilter/+1V8: C3.2, TP13.1, U5.8 (VCCB), U6.5 (VOUT)
/RFSwitchFilter/+3V3: C4.2, TP14.1, U3.6 (VDD), U4.6 (VDD), U7.5 (VOUT)
/RFSwitchFilter/ANT: J9.1 (In), U3.11 (RFC)
/RFSwitchFilter/CNTR_V1: J1.3, U5.2 (A1)
/RFSwitchFilter/CNTR_V2: J1.2, U5.3 (A2)
/RFSwitchFilter/FILTERA_IN: U3.1 (J1), U4.9 (J2)
/RFSwitchFilter/FILTERB_IN: U3.9 (J2), U4.1 (J1)
/RFSwitchFilter/FILTERC_IN: U3.3 (J3), U4.3 (J3)
/RFSwitchFilter/FILTER_OUT: J10.1 (In), U17.8 (OUT)
/RFSwitchFilter/INT_CTRL_V1: U3.4 (V1), U4.5 (V2), U5.7 (B1)
/RFSwitchFilter/INT_CTRL_V2: U3.5 (V2), U4.4 (V1), U5.6 (B2)
/RFSwitchFilter/VDD_REF: J1.4, U5.1 (VCCA), U5.4 (~OE)
/SMDFilter/GND: J11.2 (Ext), J15.2 (Ext), U15.2 (GND), U15.3 (GND), U15.4 (GND), U15.5 (GND), U15.6 (GND), U15.7 (GND), U15.9 (GND), U15.10 (GND), U15.11 (GND), U15.12 (GND), U15.13 (GND), U15.14 (GND)
/SMDFilter/SIGNAL_IN: J11.1 (In), U15.1 (IN)
/SMDFilter/SIGNAL_OUT: J15.1 (In), U15.8 (OUT)
unnamed: C8.1, J7.1 (VBUS), J8.1 (VBUS), R3.1, TP8.1
unnamed: L2.1, U14.1 (SW), U14.2 (SW), U14.3 (SW)
unnamed: D1.1, F2.2, Q1.1 (D), TP1.1
unnamed: Q1.2 (G), R1.1, TP3.1
unnamed: C9.1, C10.1, Q1.3 (S), TP2.1, U14.10 (AVIN), U14.11 (PVIN), U14.12 (PVIN), U14.13 (EN)
unnamed: C6.2, U13.4 (BP)
unnamed: C5.1, R4.1, TP5.1, U13.1 (IN), U13.3 (~SHDN)
unnamed: C6.1, C7.1, F3.1, TP6.1, U13.5 (OUT)
unnamed: R2.2, U14.4 (PG)
unnamed: C11.2, U14.9 (SS_TR)
unnamed: U4.11 (RFC), U17.1 (IN)
