Glaubinator/Radio-Telescope-RCA/CAD/KiCad PCB-Schematic/RCA Radio Telescope (MultiPCB)/KiKit Exports/Filter Control/FC_V1-1/FC_PCB_Rev1-1.kicad_pcb

## KiCad design CAD/KiCad PCB-Schematic/RCA Radio Telescope (MultiPCB)/KiKit Exports/Filter Control/FC_V1-1/FC_PCB_Rev1-1.kicad_pcb (2025-04-04)

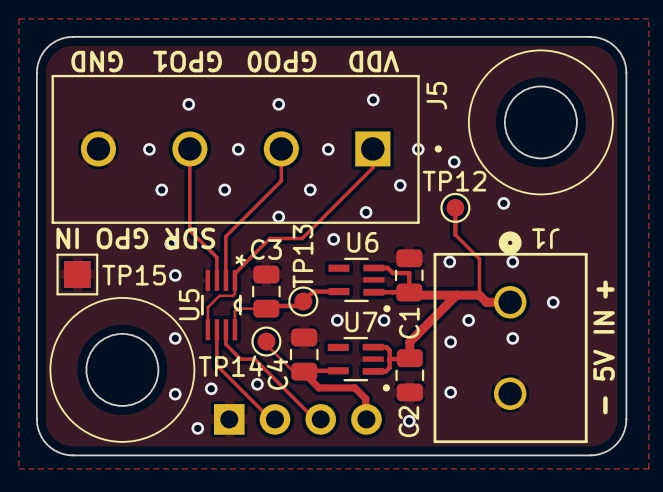
[picture p41: board FC_PCB_Rev1-1.kicad_pcb from above]

Board: 2 copper layers, 32.8 x 23.2 mm, 15 parts (1 on the bottom side), 9 nets.

Parts:
C1, C2, C3, C4: 1 uF; C_0805_2012Metric
FC: Kikit_Board_Label
J1: 5V In For Filter Board; CONN_1729128_PXC
J5: Input from SDR; PHOENIX_1729144
J11: Screw_Terminal_01x04; PinHeader_1x04_P2.54mm_Vertical
TP12: FCTRL_VIN; TestPoint_Pad_D1.0mm_Edit
TP13: FCTRL_1V8; TestPoint_Pad_D1.0mm_Edit
TP14: FCTRL_3V3; TestPoint_Pad_D1.0mm_Edit
TP15: FCTRL_GND; TestPoint_Pad_1.5x1.5mm_Edit
U5: SN74AVC2T45DCUR; DCU8
U6: MIC5365-1.8YC5-TR; SOT65P210X110-5N
U7: MIC5365-3.3YC5-TR; SOT65P210X110-5N

Connections:
/FILTERCTRL_GND: C1.2, C2.2, C3.1, C4.1, J1.2, J5.4, J11.1, TP15.1, U5.4 (GND), U6.2 (GND), U7.2 (GND)
/FiltersCTRL/5V_IN: C1.1, C2.1, J1.1, TP12.1, U6.1 (VIN), U6.3 (EN), U7.1 (VIN), U7.3 (EN)
/FiltersCTRL/+1V8: C3.2, TP13.1, U5.8 (VCCB), U6.5 (VOUT)
/FiltersCTRL/+3V3: C4.2, J11.4, TP14.1, U7.5 (VOUT)
/FiltersCTRL/VSEL_1: J11.3, U5.7 (B1)
/FiltersCTRL/VSEL_2: J11.2, U5.6 (B2)
/SDR_GPO_0: J5.2, U5.2 (A1)
/SDR_GPO_1: J5.3, U5.3 (A2)
/SDR_GPO_VDD: J5.1, U5.1 (VCCA), U5.5 (DIR)
