Glaubinator/Radio-Telescope-RCA/(commit log)

2024-12-31 Setting up repository
    [Bill of Materials V1.xlsx]
2025-02-02 Adding Decision Matrices
    [LNA.xlsx, SDR Software.xlsx, SDR.xlsx]
2025-02-08 V1 BOM
    [Bill of Materials V1.xlsx]
2025-02-09 Added LNA and Antenna
    [RCA Radio Telescope.kicad_sch]
2025-02-10 Updated Schematic
    Added SDR, Battery (incomplete)
    [RCA Radio Telescope.kicad_sch]
2025-02-12 Updated Schematic
    Updated schematic with buck board, and foundation for Power Over Ethernet.
    [RCA Radio Telescope.kicad_sch]
2025-02-12 Updated Schematic to v1.1
    - Added PoE, Power Supply components
    - Laid out components on base side
    - Added details about voltages for PoE
    - Updated and added symbols for Pluto, Ethernet Dongle, PoE Injector/Splitter, and Boost Converter
    [RCA Radio Telescope.kicad_sch]
2025-02-15 Revised BOM name for version control
    [Bill of Materials.xlsx]
2025-02-15 BOM V2 Updated
    [Bill of Materials.xlsx]
2025-02-22 V3 BOM
    [Bill of Materials.xlsx]
2025-02-24 Update Schematic to Version 1.2
    - Removed Buck Converter
    - Added Section for Step Down (need to find one that is good and can provide smooth voltage)
    - Added USB schematic symbols
    [RCA Radio Telescope.kicad_sch]
2025-02-28 Updated Schematic
    Updated System Schematic to v1.3
    -Add Hierarchal Schematics for Filters and Power/Data Distribution
    Updated Filters Schematic to v1.0
    - Added circuitry for RF switching, level shifting, and power supply.
    - Added placeholders for filters
    Updated Power/Data Distribution Schematic to v1.0
    - Added placeholders for input and output voltage
    - Added placeholders for stepdown and power filters
    - Added USBA connectors for Ethernet and SDR connectivity
    [Filters.kicad_sch, PowerDataDistribute.kicad_sch, PowerDistribute.kicad_sch, RCA Radio Telescope.kicad_sch]
2025-03-01 V4 BOM
    [Bill of Materials.xlsx]
2025-03-01 Updated Filter Select Script to v1.0
2025-03-01 Updated Filter Select Script to v1.1
2025-03-05 Updated Schematic
    Updated Root Schematic to v1.4
    - Added Screw Terminals for 5V In/Out, 3V Out for LNA
    - Reorganized Skylark Shed Power to include Battery, Inverter, and AC-DC Adapter
    - Added TODO list
    Updated PowerDataDistribute Schematic to v1.1
    - Removed labels for USB signals and replaced it with single USB_OUT signal
    [Filters.kicad_sch, PowerDataDistribute.kicad_sch, RCA Radio Telescope.kicad_sch]
2025-03-06 Updated Schematic
    Updated Root Schematic to v1.5, Filters to v1.1, and PowerDataDistribute to v1.1.
    - Updated part references to be more consistent
    - Added missing GND label for SDR GPO
    [Filters.kicad_sch, PowerDataDistribute.kicad_sch, RCA Radio Telescope.kicad_sch]
2025-03-07 Updated Filter Schematic to v1.2
    - Fixed switch logic to better suit the footprint layout (Swapped J1 and J2 on one switch (secondary one) and swapped the v1 and v2 pins on the same switch)
    [Filters.kicad_sch, RCA Radio Telescope.kicad_pcb]
2025-03-14 Updated PowerDataDistribute Schematic to v1.3
    - Added 5V to 3V Buck for LNA
    - Added TVS diode, PMOS, and polyfuse for power protection (need to select PMOS and polyfuse)
    [Filters.kicad_sch, PowerDataDistribute.kicad_sch, RCA Radio Telescope.kicad_sch]
2025-03-16 v5 BOM
    [Bill of Materials.xlsx]
2025-03-16 Updated PowerDataDistribute schematicto v1.4
    - Added components for fuses and PMOS
    - Created PCB v1.0
    [Filters.kicad_sch, PowerDataDistribute.kicad_sch, RCA Radio Telescope.kicad_pcb, RCA Radio Telescope.kicad_sch]
2025-03-16 Updated Power/Data Distribute Board to v1.1
    - Adjusted screw hole positions
    - Adjusted screw terminal positions
    [RCA Radio Telescope.kicad_pcb]
2025-03-17 BOM Update and Schematic Update
    [Bill of Materials.xlsx, Filters.kicad_sch]
2025-03-17 Fixed Double Counting on BOM
    [Bill of Materials.xlsx]
2025-03-22 Updated PowerData Board to v1.2
    - Added zone fills for certain pins
    - Added ground vias for mounting holes
    - Minor readjustments to components
    - Added silkscreen for voltage polarity
    [Filters.kicad_sch, PowerDataDistribute.kicad_sch, RCA Radio Telescope.kicad_pcb, RCA Radio Telescope.kicad_sch]
2025-03-25 Updated Power Data Distribute PCB to v1.3
    - Rearranged 5 to 3V PCB layout to fit new circuit
    - Added via stitching to PCB
    - Added some constraints supplied by JLCPCB
    [RCA Radio Telescope.kicad_pcb]
2025-03-25 V1.5 Schematic and 1.4 PCB Layout
    [PowerDataDistribute.kicad_sch, RCA Radio Telescope.kicad_pcb]
2025-03-25 Updated Power/Data Schematic to v1.6 and Power/Data PCB to v1.5
    - Added Testpoints to both Schematic and PCB
    - Rearranged components on PCB to fit missing diode
    - Changed Zener diode and PMOS on Protection Circuit to work with 12V max
    - Fixed warnings and errors from DRC
    [Filters.kicad_sch, PowerDataDistribute.kicad_sch, RCA Radio Telescope.kicad_pcb, RCA Radio Telescope.kicad_sch]
2025-03-26 Updated PowerData PCB to v1.6 and PowerData Schematic to v1.7
    - Design Review with Andrew
    - Fixed up various parts of PCB parameters
    - May consider LDO or filtering for Power IC
    - May want to consider a circuit breaker IC for LNA supply
    [PowerDataDistribute.kicad_sch, RCA Radio Telescope.kicad_pcb, RCA Radio Telescope.kicad_sch]
2025-03-28 Updated PowerData Schematic to v1.8 and PCB to v1.7
    - Swapped MIC Buck to LDO
    - Changed footprint for Buck Inductor to appropriate component
    - Rearranged PCB layout to accommodate new inductor
    [PowerDataDistribute.kicad_sch, RCA Radio Telescope.kicad_pcb]
2025-03-28 Updated PowerData Schematic to v1.9 and PCB to v1.8
    - Swapped LDO (Obsolete) with an Active version in both Schematic and PCB
    [MAX8510EXK30T.step, PowerDataDistribute.kicad_sch, RCA Radio Telescope.kicad_pcb]
2025-03-28 small adjustment to boardsetup
    only changed one thing called min connection width from 0 -> 0.1mm on board setup
    [RCA Radio Telescope.kicad_pcb]
2025-03-29 Updated PowerData Schematic to v2.0 and PCB to v1.9
    - Added 0 Ohm resistors to modularized PCB
    - Adjusted some GND vias to prevent clipping of silkscreen
    - Edited LDO footprint to adhere with JLC specs
    [PowerDataDistribute.kicad_sch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]
2025-03-29 Updated PowerData PCB to v2.0
    - Readjusted some via holes and grounding for Buck
    - Adjusted location for testpoint and silkscreens
    [RCA Radio Telescope-B_Cu.gbl, RCA Radio Telescope-B_Mask.gbs, RCA Radio Telescope-B_Paste.gbp, RCA Radio Telescope-B_Silkscreen.gbo, RCA Radio Telescope-Edge_Cuts.gm1, RCA Radio Telescope-F_Cu.gtl, RCA Radio Telescope-F_Mask.gts, RCA Radio Telescope-F_Paste.gtp]
2025-03-29 Updated PowerData PCB to v2.1
    - Added custom JLC rules from https://github.com/Cimos/KiCad-CustomDesignRules/tree/main
    - Adjusted silkscreen according to new rules
    - Added step models for components
    - Adjusted via locations to be more spread out
    [1729128.stp, DFN2020E-6_STP.STP, IND_CB_DRA73.step, PowerDataDistribute.kicad_sch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]
2025-03-29 Updated Root Schematic to v1.6 and P/D PCB to v2.2
    - Changed input voltage to P/D board to 9-12V (Concerned about voltage drop of components which may not allow for 5V out)
    [Filters.kicad_sch, PowerDataDistribute.kicad_sch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]
2025-03-30 Rename Gerber Zip
2025-03-31 KiKit Integration and Multi Schematic Updates
    Updated Root Schematic to V1.7 (Major Changes)
    - Needed to remove all global power symbols in every schematic/sub-schematic to use KiKit's MultiPCB workflow
    - Changed them to local labels
    Added Filters V1 and FiltersCTRL V1.4
    - Separated Filter Board into two schematics: Filters and FIltersCTRL
    - Continued revision number from former Filters schematic to FiltersCTRL
    FilterCTRL V1.4
    - Swapped logic shifter with larger variant (prev was too small for JLC)
    - Added pin connectors for output signals
    Filters V1.0
    - Migrated RF switches to this PCB, may use a different software for PCB design for RF board (use for reference)
    Added SkylarkShed V1.0
    -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
    [1729128.stp, 1729144.stp, DCU0008A.stp, DFN2020E-6_STP.STP, FC_PCB_Rev1-0.kicad_pcb, Filters.kicad_sch, FiltersCTRL.kicad_sch, IND_CB_DRA73.step]
2025-04-02 V8 BOM
    [Bill of Materials.xlsx]
2025-04-02 Added KiKit Board Designators to PCB editor and Library
    [RCA Radio Telescope.kicad_pcb]
2025-04-03 Fixed Slight Mistake
    No revision necessary
    [Bill of Materials.xlsx]
2025-04-04 Update to Schematic and PCB
    Filter Control Schematic to v1.5
    - Removed redundant connector symbol
    Root Schematic to v1.9
    - Adjusted pin connections for J14 and J14
    Created Matching Network PCB
    - Filter Board Schematic renamed to MatchNetwork
    - Placed RF switches, traces, holes for daughter board, and ground stitching
    [Filters.kicad_sch, FiltersCTRL.kicad_sch, MatchNetwork.kicad_sch, RCA Radio Telescope.kicad_pcb, RCA Radio Telescope.kicad_sch]
2025-04-04 Updated FC board to v1.1
    - Removed some vias to reduce required time to solder them
    - Adjusted via size to 0.4 to meet EPL specs
    -Exported as FC_V1-1 in Kikit exports
    Updated Kikit Example
    - Added a step guide on how to use tool
    - Will make a Git Wiki once done
    [FC_PCB_Rev1-1.kicad_pcb, RCA Radio Telescope.kicad_pcb]
2025-04-08 Update SMD Filter PCB to v1.0
    - Imported ADS layout for SMD filter to KiCAD PCB file
    - Added footprint for MiniCircuit Filter
    [smd_filter.kicad_pcb]
2025-04-09 Updated Schematics and PCBs
    Root Schematic to v2.0
    - Swapped Matching Network segment for SMD filter
    - Updated TODO list
    SMD Filter PCB to v1.0
    - Added filter and SMA connector footprints
    - Imported ADS trace layout
    [RCA Radio Telescope.kicad_pcb, RCA Radio Telescope.kicad_sch, SMDFilter.kicad_sch]
2025-04-09 Updated SMD Filter PCB to v1.1
    - Adjusted GND pads from 10 to 6mm
    - Added M4 Holes for mounting
    [RCA Radio Telescope.kicad_pcb]
2025-04-09 Updated SMD FIlter Board to v1.2
    - Added KiKit Label
    - Minor adjustments to PCB
    - Exported to separate project
    - Edited SMA connector footprint
    [RCA Radio Telescope.kicad_pcb, SF_PCB_Rev1-2.kicad_pcb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]
2025-04-10 Add Measurement Text for Boards
    [RCA Radio Telescope.kicad_pcb]
2025-04-11 Updated SMD FIlter Board to v1.3
    - Adjusted line length to remove 39 ohm segment
    - Updated screwholes to be correct size
    [RCA Radio Telescope.kicad_pcb, SF_PCB_Rev1-3.kicad_pcb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]
2025-04-12 Updated BOM to Rev 10
    [Bill of Materials.xlsx]
2025-04-26 Add 1.6 GHZ Matching Network PCB v1.0
    - Same design as original board, but with 1.6 GHz matching network
    [1-6GHz-SMDFilter.kicad_sch, RCA Radio Telescope.kicad_pcb, RCA Radio Telescope.kicad_sch, new_smd_filter.kicad_pcb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]
2025-04-26 Added Coupled Lines Filter PCB v1.0 and Exported PD Board Step File
    [PD_PCB_Rev2-2.kicad_pcb, PD_PCB_Rev2-2.step, RCA Radio Telescope.kicad_pcb, RCA Radio Telescope.kicad_sch, SMDFilter.kicad_sch, coupledLinesFilter.kicad_sch, coupled_lines_filter.kicad_pcb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]
2025-04-29 RF Boards Redo (WIP)
    - Overhauling current RF boards to keep 4 RF boards in total
    [MatchNetwork.kicad_sch, RCA Radio Telescope.kicad_pcb, RCA Radio Telescope.kicad_sch, RFSwitchNetwork.kicad_pcb, SMDFilter.kicad_sch, matchedDistributeFilter.kicad_pcb, matchedDistributeFilter.kicad_sch, matchedSMDFilter.kicad_pcb]
2025-04-30 Added 4 RF Board Designs into KiCAD project
    - Added Matched SMD Filter Board, Matched Distributive Filter Board, RF Switch Filter Board, and kept original SMD Filter Board
    [PowerDataDistribute.kicad_sch, RCA Radio Telescope.kicad_pcb, RCA Radio Telescope.kicad_sch, RFSwitchNetwork.kicad_pcb, SMDFilter.kicad_sch, SkylarkShed.kicad_sch, matchedDistributeFilter.kicad_sch, matchedSMDFilter.kicad_sch]
2025-04-30 Updated PCB size for RF boards, and relocated power circuitry for RF switch board
    [RCA Radio Telescope.kicad_pcb]
2025-05-02 Update RF Board Designs
    - Added Vias to SMA connector pads
    - Removed wiring for control/power wires for RF switches
    - Adjusted grounding for RF filters
    [RCA Radio Telescope.kicad_pcb]
2025-05-05 Updated RF Board Hole Data and Exported STEPs for 3D Modeling
    [MDF_PCB_Rev1-3.kicad_pcb, MDF_PCB_Rev1-3.step, MSF_PCB_Rev1-3.kicad_pcb, MSF_PCB_Rev1-3.step, RCA Radio Telescope.kicad_pcb, RFS_PCB_Rev1-3.kicad_pcb, RFS_PCB_Rev1-3.step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]
2025-05-06 Added SMA Models to Step Files
    [142-0711-821.stp, MDF_PCB_Rev1-3.kicad_pcb, MDF_PCB_Rev1-3.step, MSF_PCB_Rev1-3.kicad_pcb, MSF_PCB_Rev1-3.step, RCA Radio Telescope.kicad_pcb, RFS_PCB_Rev1-3.kicad_pcb, RFS_PCB_Rev1-3.step]
2025-05-07 Added Extra Pads and Adjust Layout
    Updated RFS PCB to v1.4
    [1729128.stp, 1729144.stp, RCA Radio Telescope.kicad_pcb, RFS_PCB_Rev1-3.kicad_pcb, RFS_PCB_Rev1-3.step, RFS_PCB_Rev1-4.kicad_pcb, RFS_PCB_Rev1-4.step]
2025-05-24 Update Level 0 and Level 1.png
    L0 and L1 filters updated
2025-05-28 BOM Revision 11
    [Bill of Materials.xlsx]
2025-05-28 Bom Rev 11 PDF
2025-06-04 Update Bill of Materials.xlsx
    [Bill of Materials.xlsx]
2025-06-06 Uploading Simulations and Measurements
    [1.dxf, dds.cfg, de_sim.cfg, eesof_lib.cfg, hpeesofsim.cfg, linecalc.cfg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]
2025-06-11 Updated Schematic to Fix USB/PMOS issues and Minor Fixes
    [PowerDataDistribute.kicad_sch, RCA Radio Telescope.kicad_pcb, RCA Radio Telescope.kicad_sch, SMDFilter.kicad_sch, SkylarkShed.kicad_sch, matchedDistributeFilter.kicad_sch, matchedSMDFilter.kicad_sch, rfswitchFilter.kicad_sch]
